rooooosh/CYR/README.md

# CYR
_Een interactief muziekspel voor mensen met de ziekte van Parkinson om hun cognitieve -en motorische vaardigheden te verbeteren._

*Projectteam: Aldo Mauro Van Hese; Rösh-Matthew Gryson*

_19/06/2025_

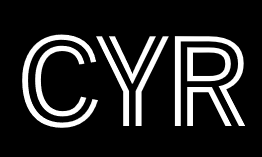
[picture p1: CYR PICS/CYR PIC.png]


## Samenvatting 

De ziekte van Parkinson is een neurologische aandoening waarvoor tot op heden nog steeds geen remedie voor bestaat. Uit literatuuronderzoek[^1] blijkt dat de verdere ontwikkeling van de aandoening een ernstige invloed heeft op de motorische vaardigheden van de persoon. Intensieve medicatie is nodig om het proces te vertragen, maar dit biedt geen permanente oplossing. Hierbij is er verder uitgediept in de Ronnie Gardiner Methode, een wetenschappelijk onderbouwde methode om cognitieve en motorische vaardigheden te stimuleren via multisensorische prikkels op basis van muziek. 

Om te voorkomen dat deze ziekte verder ontwikkeld, werd **CYR** ontworpen. **C**reate **Y**our **R**ithm is een interactief muziekspel dat helpt bij het verbeteren van de motorische -en de cognitieve vaardigheden. Deze oplossing biedt de mogelijkheid om zelfstandig muziek te maken met behulp van twee geïntegreerde modules: een **touchbox**  en een **boombox**. De gebruiker wordt opgedragen om het ritme van de afspelende muziek na te bootsen, wat een leuke maar ook uitdagende challenge vormt!

<p align="left">
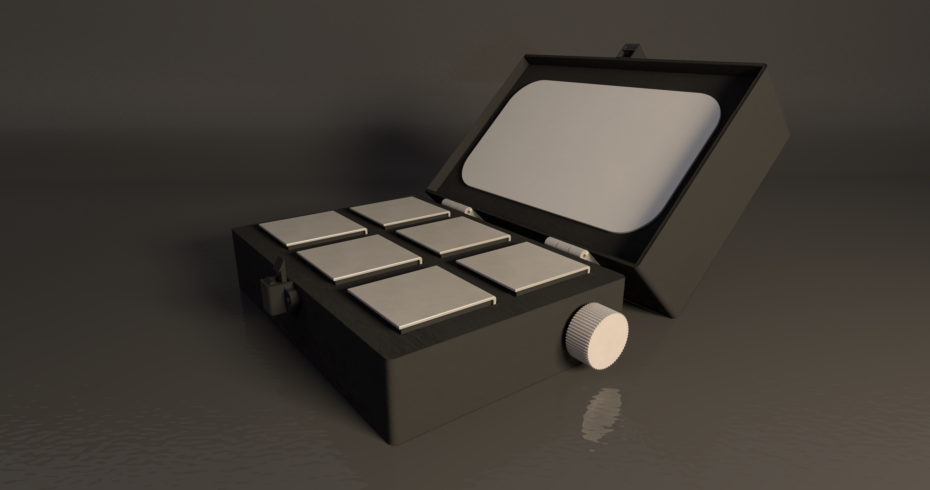
[picture p2: CYR PICS/CYR RENDER FINAAL.png]
   

> [!NOTE]
> Linken naar protocollen, rapporteringen en diepgaand onderzoek zijn te vinden in de sectie [Bijlagen](#Bijlagen).

## Introductie 

De ziekte van Parkinson is een aandoening die het vaakst voorkomt bij mensen rond 50-60 jaar. Afhankelijk van persoon tot persoon is de ontwikkelingssnelheid van de ziekte in de hersenen verschillend. Naast het innemen van medicatie staat de familie ook in voor de zorg, al is dit vaak niet evident. Naarmate de ziekte vordert, wordt het voor de familie steeds moeilijker om de benodigde zorg te bieden, waarvoor uiteindelijk wordt gekozen voor een geschikte zorginstelling om de intensieve zorg over te nemen.

Het doel van dit project is om mensen met een _vroege_ diagnose van Parkinson te begeleiden, zodanig dat de ziekte niet verergerd. De bewuste keuze om niet verder te gaan met mensen met een langere diagnose ligt aan het feit dat interactie met dagdagelijkse gebruiksvoorwerpen voor hen ingewikkelder worden. **CYR** heeft als doel om de gebruiker multisensorisch te prikkelen zodat hun cognitieve vaardigheden niet verloren gaan. De nadruk op het ontwerp ligt op het zelfstandig gebruiken van het product om de effectiviteit van de werking te garanderen. Het bestaat uit twee geïntegreerde onderdelen: een touchbox waarop muziek wordt gecreëerd en een boombox waar de gebruiker een keuze kan maken uit verschillende sets van voorgeprogrammeerde liedjes. Het ontwerp kan ook gebruikt worden in verschillende omgevingen.

We streven naar een gebruiksvriendelijk product die de gebruiker uitdaagt, maar alsnog het plezier behoudt. 

## Methodologie

Er werd in dit project gewerkt rond het 'Triple Diamond' model. Dit model bestaat uit 3 grote fasen: discover, define en develop. Het eerste semester omslaat de eerste 2 fasen. 

**Discover: |** 
Binnen de discover fase, eerste helft van het semester (week 1-6), werd individueel onderzoek gehouden van mogelijke concepten voor een vooraf gekozen doelgroep. Dit onderzoek bestond uit een literatuurstudie en het afnemen van enkele interviews. Aan het eind van deze fase werden korte pitches gehouden om de huidige concepten te introduceren. Slechts een deel hiervan kon verder bouwen op het concept. 

**Define: |** 
De define fase vond pas plaats in de tweede helft van het eerste semester (week 6-12). Na de pitches en de gekozen concepten werden teams van 2 personen samengesteld om het gekozen concept verder te zetten. Zoals de figuur van de triple diamond het laat zien, is het de bedoeling dat de concepten en oplossingen convergeren tot één werkend concept die de tweede diamond omsluit. Deze definition fase D2 werd opgesplitst in 2 waves. In elk van deze waves werden prototypes gebouwd om het concept nog meer te definiëren en bepaalde fouten in het ontwerp op te sporen. De kern van deze opdrachten was het afnemen van gebruikstests om het prototype te veranderen in functie van hun voorkeuren. 

**Develop: |**
Bij aanvang van het tweede semester (week 13) wordt de derde en laatste diamond betreden. Dit volledige tweede semester zal er gefocust worden op de develop fase. Deze fase wordt opgesplitst in 3 grote deelopdrachten elk met een bepaald doel te bereiken. 

De eerste deelopdracht heeft als doel om de fysieke, cognitieve en sensoriële ergonomie van het product te optimaliseren aan de hand van theorie, prototyping en testing. De gebouwde prototypes in wave 2 van semester 1 zullen verder verfijnd worden a.d.h.v. meerdere iteraties op beide componenten van het concept. De gebruiker zal opnieuw een keuze maken uit de verschillende iteraties waarop deze worden vastgezet tot het eind van het semester. Hierbij wordt een stap teruggenomen in het proces om zo tot voldoende feedback te komen rond de vormgeving van het product.

In develop 2 wordt de nadruk gelegd op de user experience en usability van CYR. Concreet worden de oplossingen in develop 1 verder verfijnd waarbij opnieuw gebruikstests worden uitgevoerd om zo voldoende feedback te verzamelen. 

In develop 3 wordt de focus gelegd op het optimaliseren van de esthetische vormgeving en de interactie-elementen van het prototype. Concreet wordt er gestart vanuit het verzamelen van gebruikersfeedback op basis van verschillende ontwerpvoorstellen voor zowel de look & feel van het spel als de fysieke componenten, zoals de integratie van een kliksysteem en een ondersteuningshendel. Door middel van gerichte SAM-tests en het vergelijken van alternatieve designopties zullen de voorkeuren en behoeften van de doelgroep in kaart worden gebracht. De inzichten uit deze sessies worden vertaald naar concrete aanpassingen in het eindprototype. Er zal nadruk gelegd worden op gebruiksgemak, visuele aantrekkelijkheid en praktische functionaliteit.

**Deliver: |**
Na het einde van de develop fase volgt de deliver fase. In deze fase wordt het finale concept gepresenteerd, het eindprototype vervaardigd, visuele beelden opgesteld en wordt er een video deliverable gemaakt.

<p align="left">
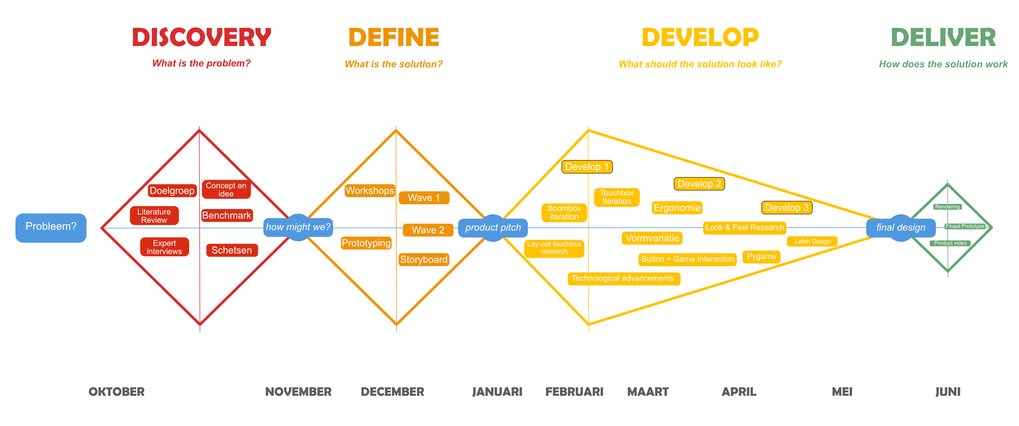
[picture p3: CYR PICS/TIJDLIJN2.jpg]
   

## Discovery

### Doestellingen
De keuze om te werken rond mensen met Parkinson maakte het noodzakelijk om voldoende met gebruikers in contact te staan bij het maken van bepaalde ontwerpkeuzes. Het grootste doel is om een product te ontwerpen dat een positieve, stimulerende invloed heeft op de gebruikers. Deze positieve invloeden zouden zowel wetenschappelijk een voordeel moeten bieden als een positieve invloed op het humeur en gedrag van de gebruiker. 

### Materiaal & methoden
Door een grondige verkenning van de onderzoeksopdracht, gebaseerd op een uitgebreide literatuurstudie en diepgaande expertinterviews, werd de verdere onderzoeksrichting zorgvuldig bepaald. Parallel aan de uitvoering van het onderzoek ontstonden de eerste conceptuele ideeën, waarbij inzichten uit de analyse direct bijdroegen aan de ontwikkeling van innovatieve oplossingsrichtingen.

#### Expert interviews (N=3)
De expert interviews werden uitgevoerd om _early_ feedback van de gebruikers te verzamelen die hielpen bij het bedenken van concepten. Uit de interviews kwam vooral naar voren dat de respondenten erkenden dat er een behoefte en marktruimte bestaat voor een nieuw product. Het zou een handig hulpmiddel zijn voor mensen met Parkinson, waarbij er minder extra medicatie moet genomen worden. 

Op basis van de interviews worden hier de belangrijkste zaken aangehaald.

| **Naam** | **Relatie tot patiënt** | **Belangrijkste inzichten** | **Opmerkingen over muziek en RGM** |
|---|---|---|---|
| **Gaston Vermeulen** | Patiënt (68 jaar) | - Parkinson sinds zijn 45ste.<br>- Kan nog stappen, maar fijne motoriek is moeilijk<br>- Heeft moeten stoppen met muziek spelen (saxofoon, fluiten), wat hij pijnlijk vond<br>- Open voor nieuwe producten, vooral met muzikale en ritmische aspecten | - Interesse in ritme/melodie-gebaseerde producten<br>- Voelt zich ongemakkelijk bij groepsactiviteiten<br>- Vond het voorgesteld concept leuk, ziet uitdaging als motivatie |
| **Monique Deurinck** | Partner van patiënt | - Mantelzorger van echtgenoot Marcel (10 jaar Parkinson)<br>- Marcel kan niet meer zelfstandig bewegen, woont in een woonzorgcentrum<br>- Merkte de symptomen op in fijne motoriek<br>- Medicatie wisselde vaak, niet altijd effectief | - Marcel vindt zingen in de woonzorgactiviteiten plezierig, minder schaamte in de sociale setting<br>- Skeptisch over effectiviteit van een product, maar ziet potentieel in motivatie en muziek |
| **Annabelle Vermeulen** | Zus van Gaston | - Mantelzorger van Gaston (23 jaar Parkinson)<br>- Helpt met dagelijkse taken, voelt emotionele impact van zijn achteruitgang<br>- Gaston heeft mentale en fysieke moeilijkheden, confronterend voor beiden<br>- Positief over nieuwe oplossingen | - Gaston heeft muzikale achtergrond, voelt geluk bij het spelen van muziek<br>- Gelooft dat muzikale en fysieke acties effectief kunnen zijn, vooral met een motiverende insteek |

#### Literatuuronderzoek (N=10)
Literatuuronderzoek uitvoeren is cruciaal om goed geïnformeerd te zijn wanneer je werkt rond een doelgroep met een bepaalde aandoening of ziekte. Via een internet research werd tal van relevante informatie gevonden die het project verder kon helpen bij het opstellen van een goede onderzoeksvraag. De literatuurstudie wees uit dat muziek het meest prominente focuspunt vormt voor verdere ontwikkeling binnen dit onderzoek. Het is bewezen dat muziek en ritme een positieve invloed hebben op mensen met Parkinson.

#### Conceptselectie
De concepten die uit het vooronderzoek kwamen, waren allemaal gericht op muziek. De keuze om met **CYR** verder te gaan, was vanzelfsprekend. Dit concept sluit het beste aan bij het verlopen onderzoek. In de andere concepten stond muziek meer centraal. De kern bij **CYR** ligt vooral bij ritme en timing die een oplossing zou moeten geven voor dit project.
<p align="left">
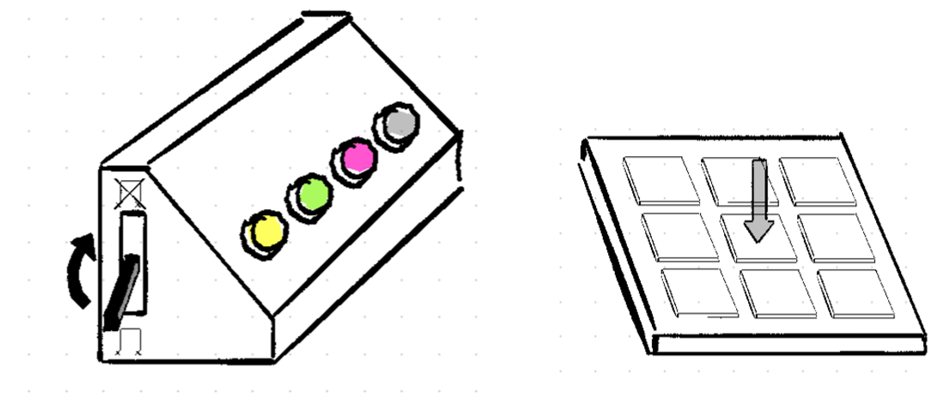
[picture p4: CYR PICS/modules.png]
   

## Definition (N=10)

### Doelstellingen
Vanuit het vooropgestelde onderzoek werd een prototype gebouwd, die het ritme van muziek kon construeren op een gekozen set van liedjes. Vanuit de eerste wave werd het prototype aangepast aan de voorkeur van de gebruiker. Uit deze feedback werden de volgende stappen genomen voor wave 2.

### Materiaal & methoden
De gebruikstesten zullen plaats vinden in 2 waves. De eerste wave legt de focus op de interactie tussen het prototype (zowel touchbox als boombox) en de gebruiker. Hierbij was de bedoeling om enige ongemakken tijdens het gebruik op te sporen en de interactie zo goed mogelijk te optimaliseren. Er werd getest met drukknoppen (verschillende groottes) en hendels waarvan de functies later worden besproken. Wat getest zal worden in wave 2 is afhankelijk van de feedback uit wave 1. Voor het prototypen werd er gebruik gemaakt van mdf, karton, metalen plaatjes en Makey Makey. 

Er zijn twee prototypes van de boombox in verschillende formaten gemaakt om de voorkeuren weer te geven die in elk van de waves naar voren kwamen. De boombox heeft als doel om een liedje te selecteren en biedt de keuze om dit met of zonder percussie te doen via een keuzehendel of aan-/uitknop. Het grotere prototype kreeg aan de zijkant de hendel, het kleinere prototype de knop. Deze keuze was onbewust en kon uiteraard aangepast worden indien nodig. Op beide boomboxen werden grote knoppen gemonteerd die de keuze liet geven uit een aantal liedjes. 

Vooraf aan de bouw van het touchbox werden de dimensies zodanig gekozen dat er genoeg plaats voor de elektronica en de plaatjes die moeten bevestigd worden. In totaal werden 9 gelijke metalen plaatjes gemonteerd, 3 plaatjes per 3 rijen. In het verdere verloop van dit project zou kunnen gewerkt worden met minder of meer plaatjes, deze keuze kan nog verandert worden in de loop van de tijd. 

_Foto 1: Touchbox_;
_Foto 2: Kleine boombox_;
_Foto 3: Grote boombox_

<p align="left">
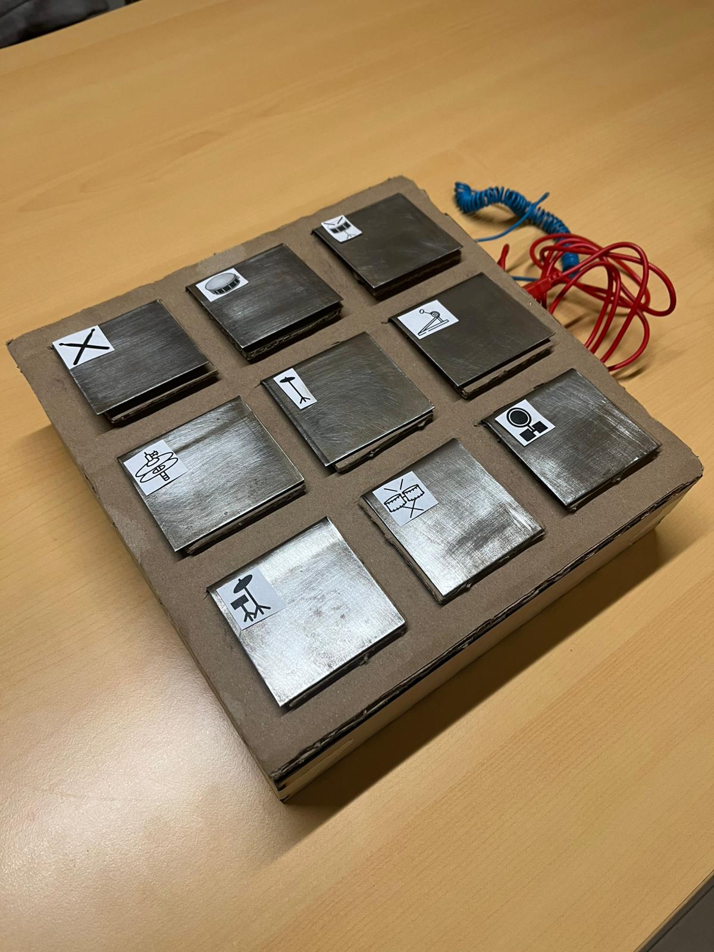
[picture p5: CYR PICS/Touchbox2.jpg]
  
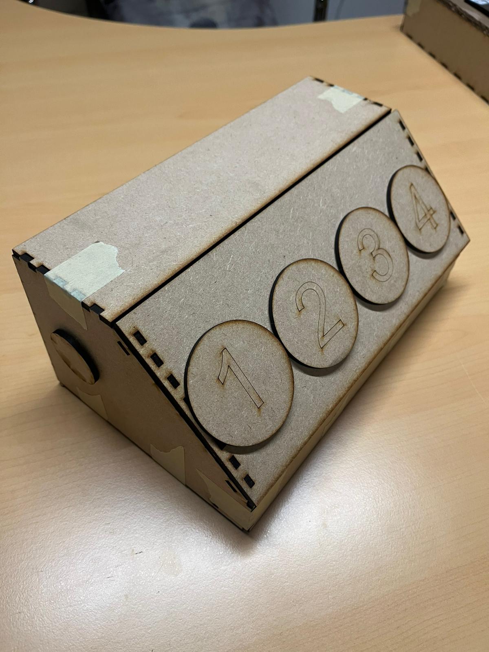
[picture p6: CYR PICS/Hoofdbox1.jpg]
  
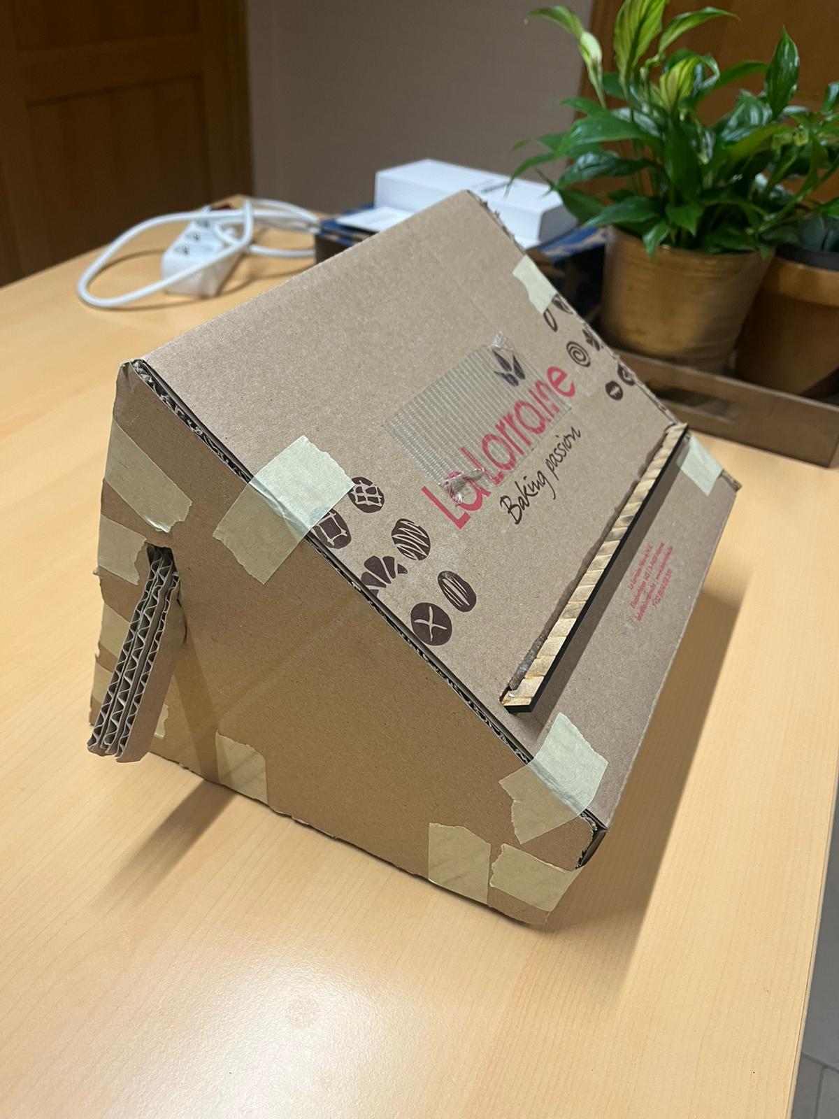
[picture p7: CYR PICS/Hoofdbox2.jpg]
  

In wave 1 werden de verschillende toetsen van de touchbox aangeduid met hun bijhorende naam. Door de vele verwarring en beperkte kennis over een drumstel werd er overgeschakeld naar een alternatief met icoontjes in wave 2. Door het gebruik van icoontjes op de toetsen kreeg de gebruiker meer voeling om het ritme goed na te bootsen.

<p align="left">
  
  

#### Inspiratie
Het idee om een muziekspel te maken stamde af op het idee dat leek op Guitar Hero, een spel waarbij de gebruiker wordt opgedragen om te tikken op de volgorde van toetsen die worden gegeven. Wanneer de speler op een verkeerde toets drukte, of deze te laat indrukte heeft de speler verloren en moet deze proberen het level opnieuw te spelen. 

In wave 2 werd een spel geprogrammeerd waarin **CYR** op een vergelijkbare manier functioneert. Het spel werd gemaakt met Protopie waarbij eenvoudig verschillende layouts werden gemaakt. De gebruiker krijgt aan het begin van een liedje een opeenvolging van voorgeprogrameerde "pictogrammen" te zien op het scherm van de boombox die corresponderen met de icoontjes op de touchbox. In dit geval werd er gebruik gemaakt van een Ipad als scherm.

Het doel is om op het juiste moment deze toetsen in te drukken die vervolgens mooi aansluiten op het ritme van de afspelende muziek. Wanneer de gebruiker een foute toets indrukt of te laat indrukt wordt er niet opnieuw gestart, maar wordt er simpel weg aangegeven dat de handeling niet correct werd uitgevoerd. Om op deze manier een spel te creëren dat de uitdaging blijft behouden met de gebruiker, slaagt **CYR** erin om zowel cognitie als motoriek te blijven trainen.

<p align="left">
  
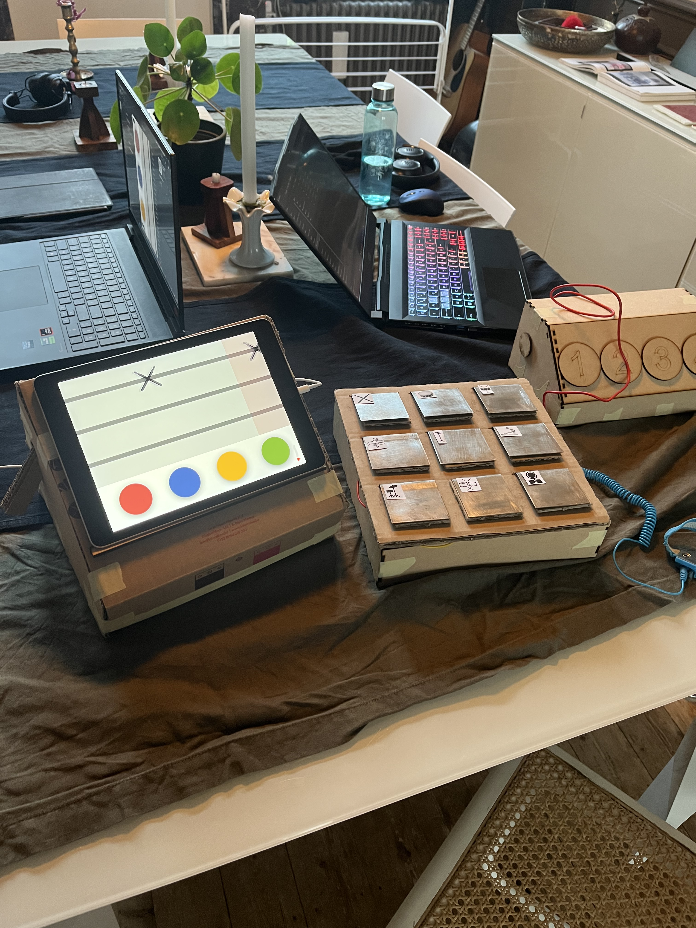
[picture p9: CYR PICS/CYR met Ipad volledige setup 1.jpeg]
  
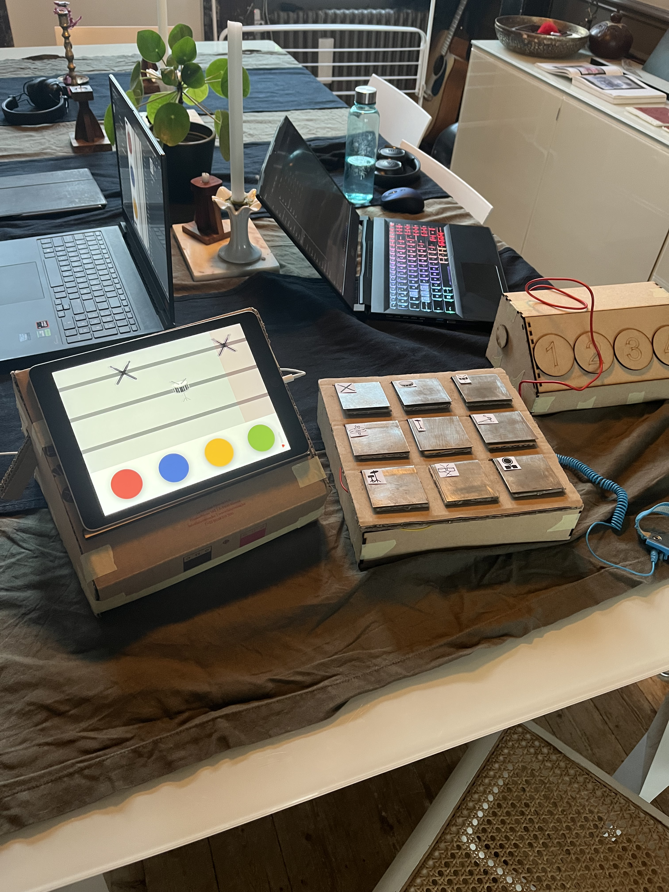
[picture p10: CYR PICS/CYR met Ipad volledige setup 2.jpeg]
  

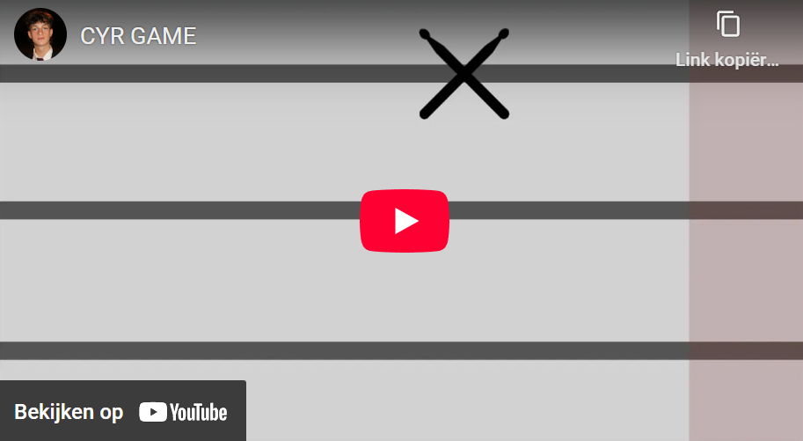
[picture p11: CYR PICS/Thumbnail.png]
[](https://youtu.be/sCeQrx-kPlM)

#### Makey Makey
Het afspelen van geluid na indrukken van de toetsen wordt mogelijk gemaakt door [Makey Makey](https://makeymakey.com/). 

<p align="left">
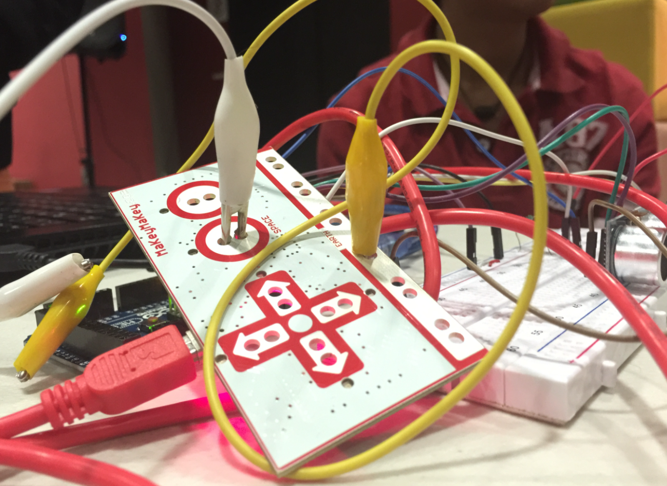
[picture p12: CYR PICS/Makey Makey 1.png]
  
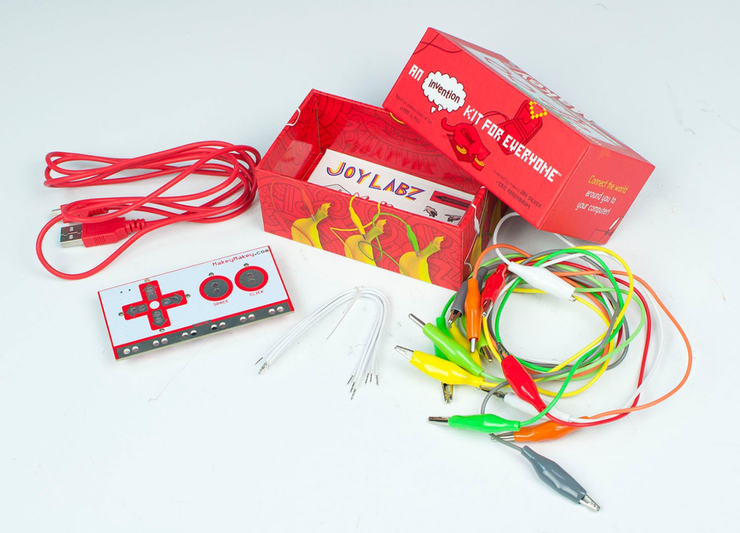
[picture p13: CYR PICS/Makey Makey 2.png]
  

Om muziek te imiteren wordt gekozen om verder te werken op drumpercussie. Elk van de toetsen wordt gelinkt met een andere component van een drumstel. De hendel of aan-/uitknop die eerder werd aangehaald, geeft de mogelijkheid om de percussie van het afspelende lied aan of uit te zetten. Dit kan voor de gebruiker een grotere uitdaging vormen. Om de touchbox te kunnen gebruiken werd voor het uitvoeren van de test gevraagd aan de gebruiker om een polsbandje om te doen zodat er directe verbinding is met de Makey Makey, die op zijn beurt is verbonden met een laptop. 

> [!IMPORTANT]
> Makey Makey maakt gebruik van capacitive touch waardoor een simpele aanraking met één van de toetsen al een geluid creëert. 

### Resultaten
In wave 1 kreeg het concept positieve feedback. Gebruikers vonden het een leuk en uitdagend product, zeker voor mensen zonder ervaring met muziekspelen. Ze waardeerden de interactie met de touchbox en vonden het prettig dat ze geen knoppen hoefden in te drukken - het aanraken van de plaatjes was voldoende om feedback te krijgen. Voor mensen met Parkinson kon dit een uitdaging zijn, maar één die te overwinnen was. Een verbeterpunt was de lichte vertraging tussen het aanraken van het plaatje en het afspelen van het geluid.

Het grootste resultaat uit wave 2 was de goede ervaring met het gemaakte spel. De gebruikers vertelden dat het een leuke uitdaging was waarbij ze een duidelijke verbetering merkten bij het meermaals spelen van het spel. De moeilijkheid werd door elke gebruiker anders ervaren, dit is dan ook een persoonlijke kwestie van muziekvaardigheden. Dit is iets wat verwacht werd bij het starten van deze wave en niet als probleem werd gezien omdat het plan was om dit spel in verschillende moeilijkheden/niveaus te maken. 

Een aantal gebruikers hadden wel kritiek op de kwaliteit van het spel. De icoontjes waren niet altijd perfect getimed en vielen soms buiten het ritme. Dit kwam door de beperkingen van ProtoPie, waardoor het lastig was om de beweging van de icoontjes nauwkeurig te programmeren.

> [!NOTE]
> De gebruikstests werden uitgevoerd volgens de **Wizard of Oz** methode. _"De Wizard of Oz methode is een gemodereerde onderzoeksmethode waarbij een gebruiker interageert met een interface die autonoom lijkt te zijn, maar (geheel of gedeeltelijk) bestuurd wordt door een mens."_[^2]
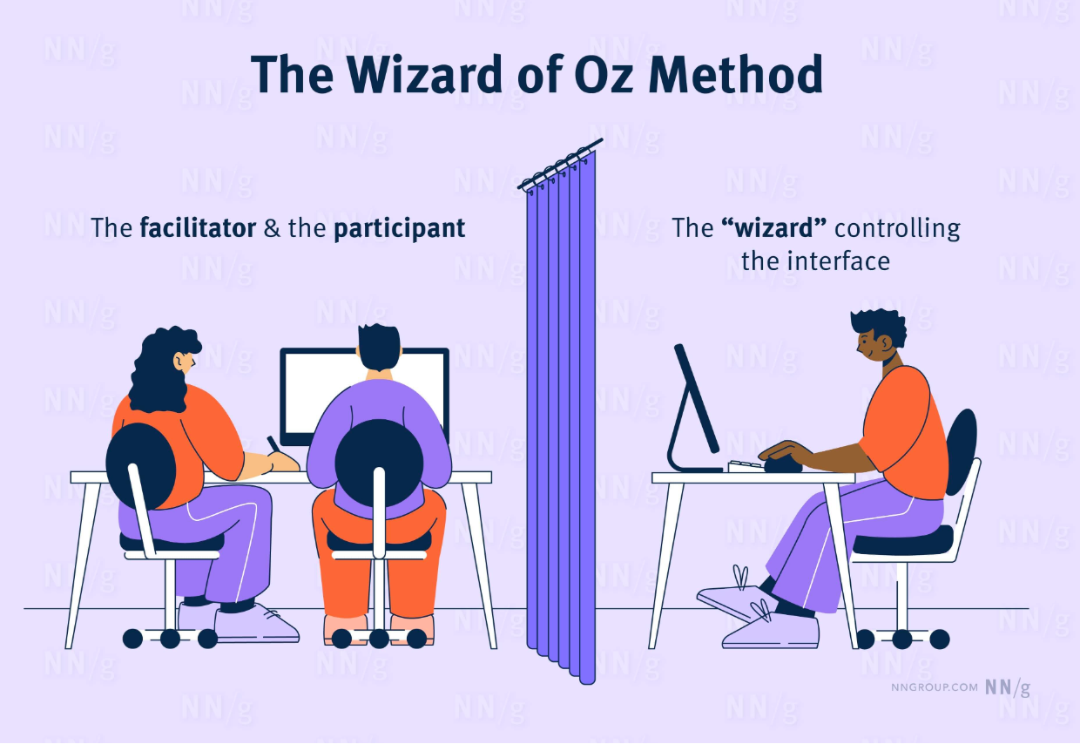
[picture p14: CYR PICS/The Wizard of Oz.png]


#### Enkele foto's met de gebruikers
<p align="left">
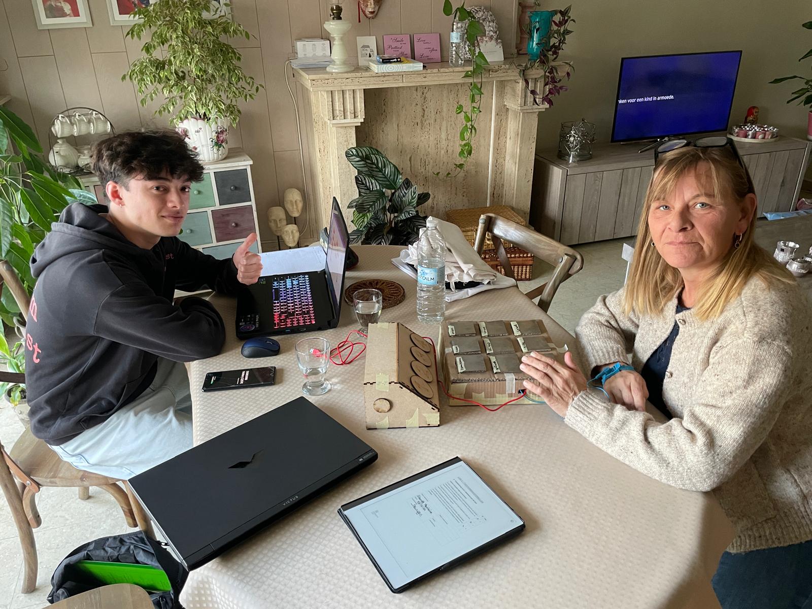
[picture p15: CYR PICS/TEST.jpg]
  
  

### Conclusies & implicaties
Op basis van de resultaten tijdens de discovery fase en uit de definition fase werd er een lijst opgesteld met de belangrijkste punten in het (voor)onderzoek:

#### Prototypes
- Een spel op basis van muziek zou de motivatie verhogen om hun conditie beter te onderhouden.
- De groottes van beide boomboxen en de touchbox zijn optimaal alsook voor de groottes van de toetsen.
- De vorm van drukknoppen op de touchbox zijn optimaal en groot genoeg van dimensies.
- Een extra uitdaging zoals meerdere spelvormen zouden het plezier nog meer naar boven halen.
- De delay op het indrukken van de toetsen was een vaak voorkomende storende factor.
- Aanduiding op de toetsen welk geluid welke toets maakte, zorgde voor een beter begrip.
- Het ritme kon iets beter nagevolgd worden m.b.v. de Ipad die werd gemonteerd aan de boombox.
- De toetsen, verbonden met Makey Makey, waren tè responsief. M.a.w. als de toets voor langere tijd werd ingedrukt, kreeg je een rare vervorming van het geluid.

#### Gebruikers
- Er was vaak een gebrek aan kennis over de verschillende componenten (van een drumstel).
- In een aantal gevallen waren de gebruikers niet compatibel voor het gebruik van het prototype door bepaalde menselijke factoren (verbinding i.v.m. Makey Makey).
- Het duurde een aantal keren voordat er werd onthouden welke toets welk geluid maakte.
- De gebruikers lieten een goed gevoel achter na afronden van de tests.
- Gebruikers met duidelijkere symptomen (vb. tremor hand) hadden meer moeite om op een toets te drukken.

> [!IMPORTANT]
> **Design requirements**
>  - 1.1 De touchbox bevat een minimale hoogte om elektronica te bewaren.
>  - 1.2 De boombox bevat een minimale grootte voor het ondersteunen van een scherm.
>  - 2.1 De touchbox produceert geluid door een enkele aanraking met één van de toetsen.
>  - 2.2 Het indrukken van de knoppen op de touchbox gebeurt aan de hand van capacitive touch.
>  - 2.3 Elke toets wordt afgebeeld met een ander symbool.
>  - 3.1 De boombox heeft een functieknop aan de zijkant om het ritme van muziek aan/uit te schakelen.
>  - 3.2 De boombox bevat verschillende knoppen om een keuze te maken uit verschillende liedjes.
>  - 4.1 De dimensies van de touchbox (25,5cm x 17,5cm) maken het mogelijk deze makkelijk op te bergen.
>  - 4.2 De drukknoppen hebben een minimale diameter 4-6cm om een keuze uit liedjes te maken.
>  - 4.3 De toetsen bevinden zich in een dicht gestapeld raster (2x2, 3x2, 3x3) om multi-touch mogelijk te maken.

## Bill of materials

- Natuurhout (vooral duurzaam, maar kwaliteitsvol hout)
- Roestvrij staal
- Arduino
- Kunststof drukknoppen/toetsen
- Digitale interfaces

## Kritische reflectie
Bij aanvang van dit project werd er veel progressie gemaakt. Na de vorming van de groepen werd er overlegd wat er goed was en wat er nog kon verbeterd worden aan het concept met de feedback gekregen uit de pitch. Hierna werd er gebrainstormd over wat er zou kunnen worden getest voor de verschillende waves. Een overgang werd gemaakt tot de prototyping fase, dit werd misschien wel wat te snel gedaan en had als gevolg dat er tijdens de tests af en toe iets onverwachts plaatsvond. Dit waren dingen zoals Protopie dat een update nodig had, een verbinding van de Makey Makey die loskwam etc. Desondanks bracht dit de positieve resultaten uit de tests niet neer. 

Waar er vooral last werd ervaren, was het contacteren van gebruikers om de waves mee uit te voeren. Door de moeilijke doelgroep was er geen optie waar alle tests op een gelijk tijdstip zouden kunnen worden uitgevoerd. De gekozen doelgroep heeft nog geen extreme zorg nodig en is niet altijd even mobiel. De meeste gebruikers hadden liever een afspraak moment bij hen thuis, wat soms voor moeilijkheden zorgde. 

Wave 1 werd initieel afzonderlijk uitgevoerd, maar een grondigere voorafgaande analyse had wenselijk geweest alvorens de momenten definitief vast te leggen.
Naar aanleiding van de eerste test binnen wave 1 werd besloten om de daaropvolgende waves simultaan af te nemen. Er werd met een tiental mensen in contact gestaan, maar door een aantal factoren kon er geen gepast moment ingepland worden om het prototype te testen. Dit had als gevolg dat er een test werd uitgevoerd met een persoon die geen Parkinson heeft, maar wel vaak in contact heeft gestaan met de doelgroep en nuttige feedback heeft kunnen geven.

Deze korte tegenslagen terzijde, verliep de samenwerking en de vooruitgang die werd gemaakt in het proces goed. Na het voltooien van de waves kan het project naar de volgende fase. De waves hebben een grote impact gehad op het project en hebben de nodige motivatie gegeven om verder te werken aan het project. De gebruikers gaven ook aan nog in contact te willen staan, wegens de grootte interesse in het concept. In de toekomst zullen deze mensen de mogelijkheid krijgen om als eersten het volmaakt prototype te testen.

## Develop 1: Definiëren van gebruiksinterfaces (N=3) 

### Doelstellingen
De oplossingen die werden gebracht in wave 2 van de definition fase, zullen verder verfijnd worden waarbij opnieuw een aantal gebruikstests worden afgelegd. Het doel is om de centrale interfaces van beide componenten vast te leggen met een aantal gebouwde iteraties.

### Materiaal & methoden
Voor deze deelopdracht wordt een stap teruggenomen waarbij er opnieuw wordt getest op de layout van de interfaces van zowel de boombox en de touchbox. Om de interfaces van de touchbox en de boombox vast te leggen, werden een aantal iteraties gebouwd:
- De touchbox bevat variaties met 4, 6, en 9 (origineel) toetsen
- De boombox bestaat uit 4 mogelijke varianten: 4 kleinere knoppen met extra respons, 2 kleinere knoppen, een draaiknop en een draaiwiel

**Touchbox**

Verschillende iteraties van de touchbox werden gemaakt met een verminderd aantal toetsen. Het origineel bevatte teveel knoppen waardoor een groot aantal niet werden gebruikt tijdens een gebruikstest. Deze bevinding stamde af van de definition fase. Ook is het moeilijk om aan elke knop een ander icoon aan te linken aangezien dat een drumstel soms overlappende elementen bevat. 

> _"Hoe meer knoppen hoe verwarrender"_
> 
> _- Een gebruiker_

Er werd ook onderzocht naar de latency van de touchbox. De kloof tussen het horen van het geluid na het indrukken van een toets is voor de meeste gebruikers nog steeds te groot. Om te zien of dit aan de software of hardware ligt zal dit probleem in vrijwel elke deelopdracht worden aangekaart. Bij deze deeldpdracht ligt de focus bij het veranderen van de **<ins>software</ins>**: het eenvoudige programma scratch wordt hierbij vervangen door Protopie als poging om deze latency te doen verminderen.

_Foto 1: Touchbox met 9 toetsen (origineel); Foto 2: Touchbox met 6 toetsen; Foto 3: Touchbox met 4 toetsen_
<p align="left">
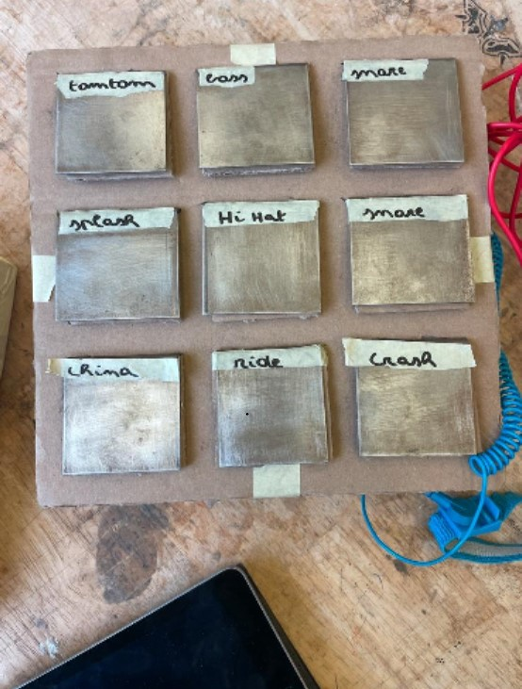
[picture p16: CYR PICS/Touchbox met 9 toetsen (origineel).jpeg]
  
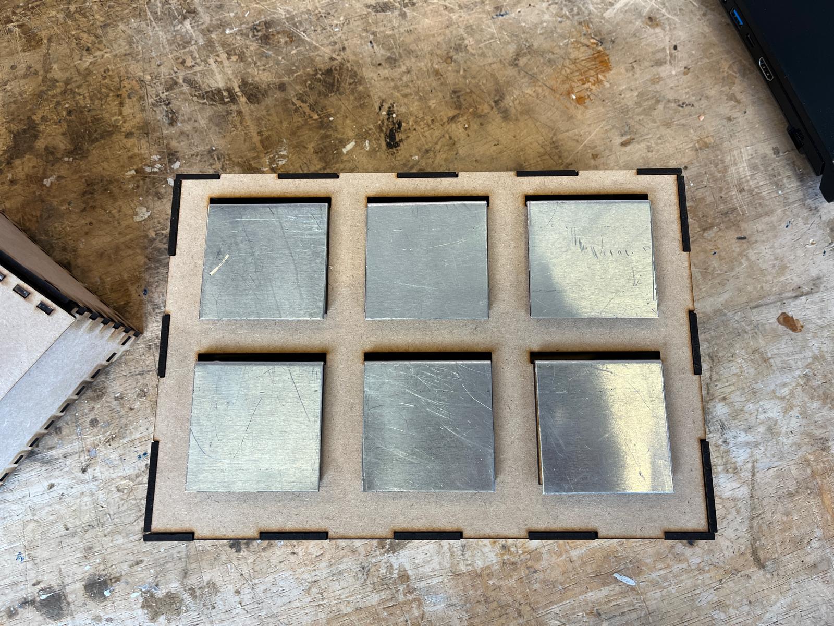
[picture p17: CYR PICS/Touchbox met 6 toetsen.jpeg]
  
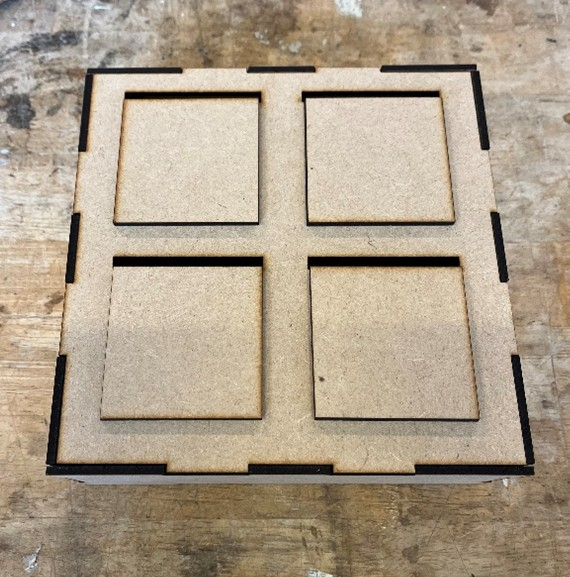
[picture p18: CYR PICS/Touchbox met 4 toetsen.jpg]
  

**Boombox**

De verschillende iteraties op de boombox bevatten interfaces die elk op een andere manier worden gebruikt.

- **1.** Het originele prototype dat 4 keuzeknoppen bevatte voor het selecteren van een liedje, werd opnieuw gebouwd met een viertal kleinere knoppen waarbij een extra respons wordt toegepast na indrukken van een knop. 

- **2.** De interface met 2 knoppen dient op gelijkaardige wijze gebruikt te worden. De interface bestaat uit een lijst van liedjes die voorgeprogrammeerd zijn en bevat ook de optie om eigen liedjes up te loaden binnen de software.
  > _"Na mum van tijd zul je die voorgeprogrammeerde liedjes zat zijn"_
  > 
  > _- Een gebruiker_
  
  De linkerknop zorgt voor het "scrollen" van de lijst naar onder, de rechterknop zorgt voor de navigatie naar boven. Om een keuze te maken uit een liedje worden simultaan beide knoppen ingedrukt. 

- **3.** De draaiknop heeft als mogelijkheid om opnieuw uit een lijst van liedjes te scrollen via een draaibeweging naar links of naar rechts. Om een liedje te selecteren wordt dan op de knop gedrukt. 

- **4.** Het draaiwiel bevat een andere manier voor het selecteren van een liedje. Het draaiwiel is via een intern draaiwiel in het iPad scherm verbonden. Wanneer er met het draaiwiel gedraaid wordt, dan zal de digitale schijf ook meedraaien volgens de beweging van het draaiwiel.

_Foto 1: Originele boombox; Foto 2: Boombox met 4 drukknoppen; Foto 3: Boombox met draaiwiel; Foto 4: Boombox met 2 drukknoppen; Foto 5: Boombox met draaiknop; Foto 6: Bird's-eye view interfaces_
<p align="left">
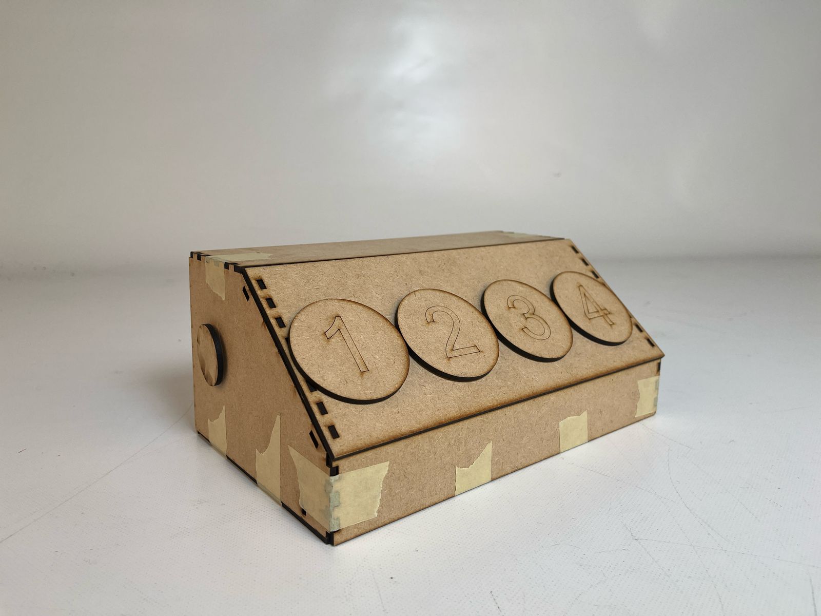
[picture p19: CYR PICS/Originele boombox.jpeg]
  
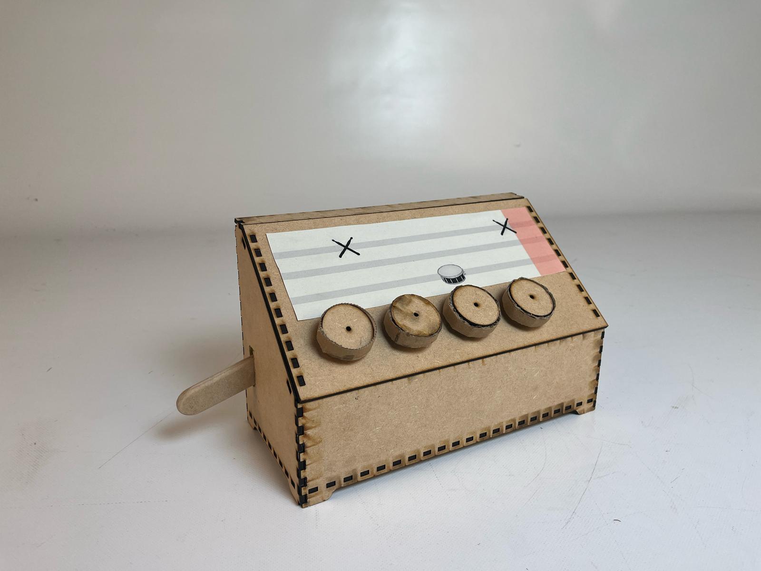
[picture p20: CYR PICS/Boombox met 4 drukknoppen.jpeg]
  
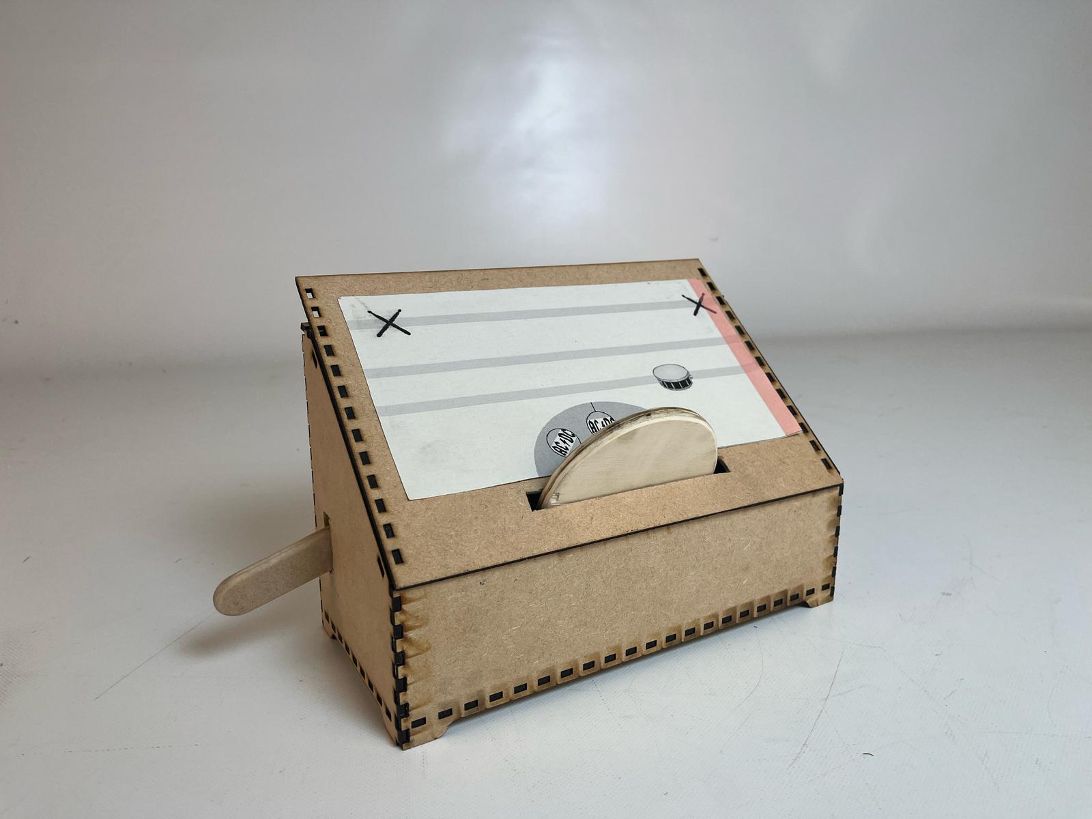
[picture p21: CYR PICS/Boombox met draaiwiel.jpeg]
  
<p align="left">
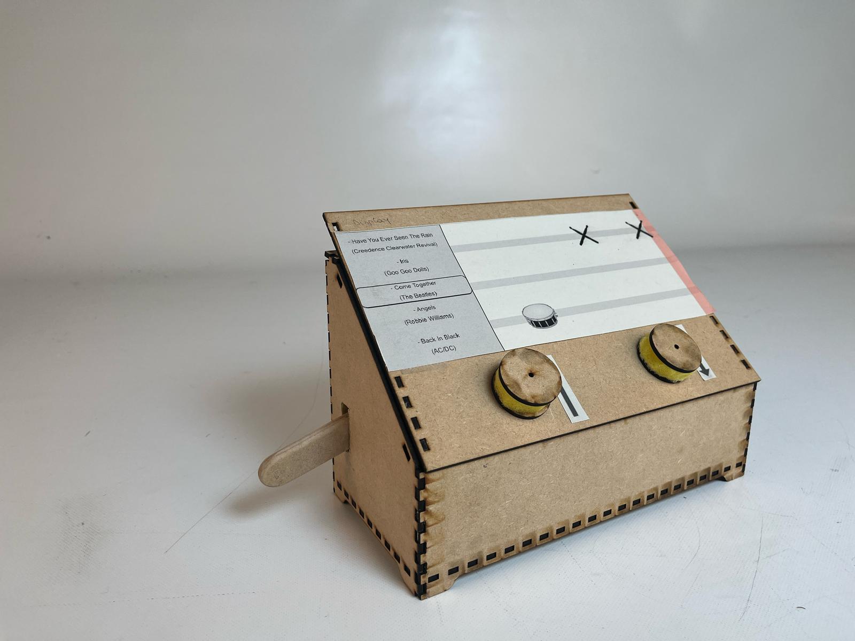
[picture p22: CYR PICS/Boombox met 2 drukknoppen.jpeg]
  
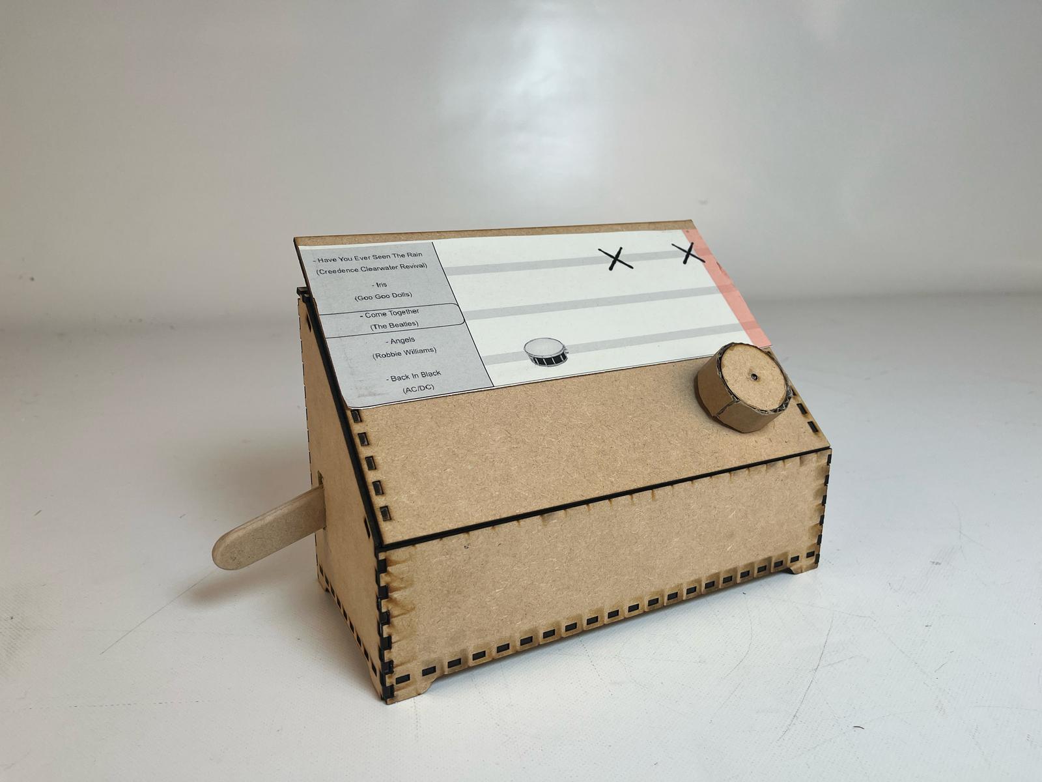
[picture p23: CYR PICS/Boombox met draaiknop.jpeg]
  
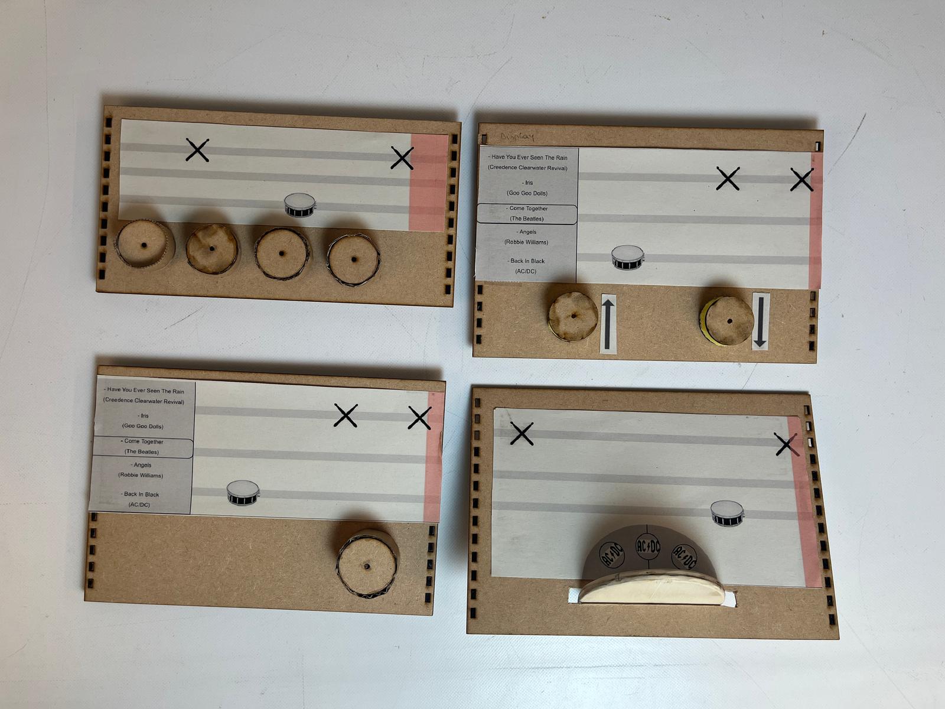
[picture p24: CYR PICS/Bird's-eye view interfaces.jpeg]
  

> [!IMPORTANT]
> Verdere ontwerpkeuzes worden toegelicht in [Protocol develop 1](https://ugentbe-my.sharepoint.com/:b:/g/personal/rosh_gryson_ugent_be/EYnQ5_UpWrZMqZonUhhwbUYB3qiD7yPpWkR4IYsoJCzTBQ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)

### Resultaten

De volgende resultaten komen rechtstreeks van het [rapport](https://ugentbe-my.sharepoint.com/:b:/g/personal/rosh_gryson_ugent_be/EcLrkE5KQL9KjGkvioypGBIBMkkocPpwzSfuyE07QG-s8w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) en zullen hier kort toegelicht worden.

---

`Gebruiker 1:` Anne <br>
`Gebruiker 2:` Sofie <br>
`Gebruiker 3:` Pieter Jan

---

#### **Touchbox MOS Test**
- 1 - zeer slecht
- 5 - uitstekend

|**Gebruiker** | **Score** | **Beperking**|
|-|-|-|
| Anne | 3 | Licht Storend | 
| Sofie | 2 | Storend|
| Pieter Jan  | 4 | Waarneembaar, maar niet storend  |
| | *Gem.: 3* ||
  
  De testpersonen ervaarden de latency op de touchbox gemiddeld gezien nog als licht storend.

#### **Varianten Touchbox** 
- 1 - meest voorkeur
- 3 - minst voorkeur

| | **9 toetsen** | **6 toetsen**| **4 toetsen** |
|-|-|-|-|
| Anne | 2 | 1 | 3|
| Sofie | 2 | 1 | 3|
| Pieter Jan  | 3 | 1  |  2|
| || *Favoriet* 

#### **Varianten Boombox** 
- 1 - meest voorkeur
- 4 - minst voorkeur

| | **Draaiknop** | **2 drukknoppen**| **4 drukknoppen** | **Draaiwiel**|
|-|-|-|-|-|
| Anne | 1 | 2| 4 | 3|
| Sofie | 2  |4  | 3 | 1|
| Pieter Jan  |1| 3 | 4  |  2|
| | *Favoriet* 

Als poging om de compactheid van CYR te bewaren, werd volgende onderzoeksvraag gesteld aan de gebruikers:

> "Zou u beide onderdelen (touchbox en boombox) liever aan elkaar verwerkt hebben of toch eerder als aparte modules behouden?"

Na een aantal interessante standpunten werden zowel de meest voorkomende voor - en nadelen gerangschikt in een tabel. 
  |**Voordelen**|**Nadelen**|
  |-|-|
  |"Zo lijkt het wat logischer, het product voelt meer aan als 1 geheel"| "Het is mogelijks moeilijker om op te bergen" |
  |"Voelt ergonomischer aan (scherm zit automatisch op een goede positie)"| "Aangezien het 1 geheel is, is het zwaarder"|
  |"Verbinding tussen elektronica zal eenvoudiger zijn"||

### Conclusies en implicaties
- Er kan gesteld worden dat de latency op de touchbox nog een probleem is, merendeel van de gebruikers merkt dit nog op en stoort zich er aan. Het veranderen van de software van Scratch naar ProtoPie voldoet niet. Een mogelijke stap naar andere hardware is een oplossing.
- Wanneer de gebruikers de verschillende iteraties op de touchbox lieten zien, werd er 1 ontwerp duidelijk vooropgesteld. Dit is het ontwerp met 6 toetsen. Hierbij werden de gebruikers ook gestimuleerd om na te denken over de hoeveelheid knoppen men dan nog tot hun beschikking zouden hebben. De eerste keus bleef behouden, dit betekent dat meer dan 6 knoppen voor de gebruiker al overbodig lijkt.
- Wanneer op dezelfde wijze de varianten op de interface van de boombox werden voorgelegd, was er een duidelijke voorkeur voor de variant met de draaiknop. De draaiknop leek de goede oplossing voor dit probleem. Het integreren van het selecteren van de liedjes in de software leek voor alle gebruikers efficiënter om zo te kunnen selecteren via 1 knop. 
- De grote van het ontworpen scherm blijkt goed te zijn. Het gaat eerder over de grote van de iconen i.p.v. de grote van het scherm.
- het spel zelf zit goed ineen, er kan mogelijks nog gespeeld worden met het kleurenpalette en een deeltje van de layout.
- Een fysieke hendel is onnodig. De functie hiervan kan worden geïntegreerd in de gekozen interface.
- De algemene mening van de gebruikers geeft weer dat ze liever de touchbox en boombox aan elkaar zouden hebben. Dit haalt een aantal praktische problemen weg en is de voor de hand liggende keuze.

> [!IMPORTANT]
> **Design requirements** 
>  - 1.3 De touchbox en boombox bevatten snap/klikverbindingen om deze aan/uit elkaar te halen.
>  - 1.4 Het product is zo compact mogelijk.
>  - 2.4 De interface van de boombox is zodanig ontworpen zodat de interactie hiermee geen overbodige elementen bevat.
>  - 2.5 Voor elke gebruiker is er een uitdagend niveau beschikbaar.
>  - 3.3 Het product maakt duidelijk met welke elementen de gebruiker kan interageren.
>  - 3.4 De touchbox is responsief en heeft een lage latency.
>  - 3.5 De hendel moet niet fysiek aanwezig zijn op de boombox.
>  - 4.4 De knoppen van de touchbox bevatten een grootte van 6x6cm.
>  - 4.5 De interactie met de boombox gebeurt aan de hand van fysieke knoppen.

## Develop 2: Focus op ergonomie (N=4)

### Doelstellingen
Uit deelopdracht 3 werden de interfaces voor zowel de touchbox als boombox vastgelegd. Het doel van deelopdracht 4 (develop 2) is nadruk leggen op de usability en user experience van CYR. 

### Materiaal & methoden
Er zal voor deze test een scherm, een draai/drukknop en nieuwe elektronica worden voorzien voor het afnemen van de tests en om een betere user experience te bieden voor de gebruikers. De draaiknop zal voorzien zijn van textuur en tactiele feedback. Een sensorial board wordt gemaakt om de gebruiker een keuze te bieden uit een aantal texturen. Een ander soort paneel wordt opgesteld om de grootte van de draaiknop te bestuderen. Gelijkaardig aan het sensorial board, worden een zestal draaiknoppen met verschillende diameters voorgesteld aan de gebruiker. Hun taak om een voorkeur te kiezen waarop verder gewerkt zal worden in de volgende deelopdracht. 

_Foto 1: Textuurbord; 
Foto 2: Bord met draaiknoppen van verschillende diameters: 30mm; 35mm; 40mm; 45mm; 50mm; 55mm_
<p align="left">
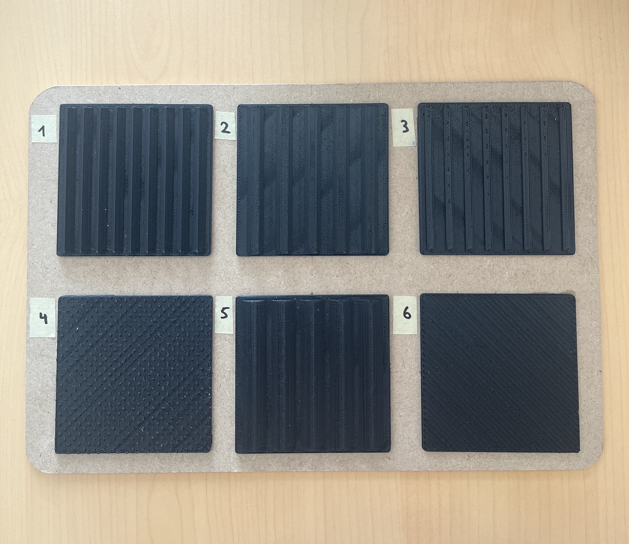
[picture p25: CYR PICS/Textuurbord.jpeg]
  
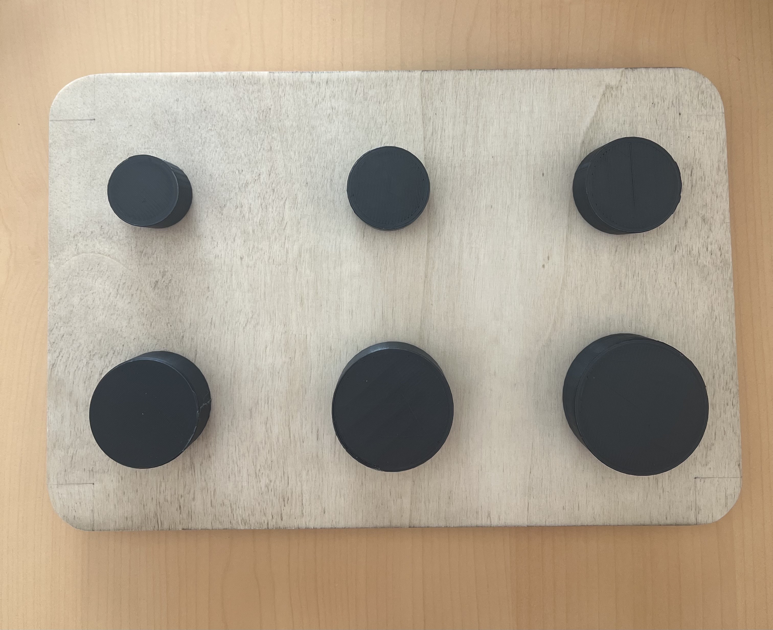
[picture p26: CYR PICS/Draaiknopbord.jpeg]
  

> [!IMPORTANT]
> Verdere ontwerpkeuzes worden toegelicht in [Protocol develop 2](https://ugentbe-my.sharepoint.com/:b:/g/personal/rosh_gryson_ugent_be/EZr1qvLegvdGhiyvLIi9aaYBGahtcbnpVLFXi5PUhK0NEA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)

Zoals in vorige deelopdrachten wordt vermeld, is het latentieverschil tussen het aanraken van het metalenplaatje en het horen van het geluid nog een te grote kloof voor onze gebruikers. Bij deze deelopdracht ligt de focus bij het veranderen van de **<ins>hardware</ins>**: als poging om de latency te verminderen, zal de Makey Makey nu worden vervangen door Arduino. 
Er wordt gewerkt met een aantal Arduino componenten:

- Arduino Nano
- 12 Key Capacitive I2C Touch Sensor (MPR121)
- MP3-TF-16P V3.0 (DF player mini)
- Weerstand 1,2kΩ
- Speaker 3W - 5Ω

_Foto 1: Arduino Nano met DF player mini en speaker; 
Foto 2: I2C Touch Sensor met krokodillenklemmen; 
Foto 3: Volledige opstelling_
<p align="left">
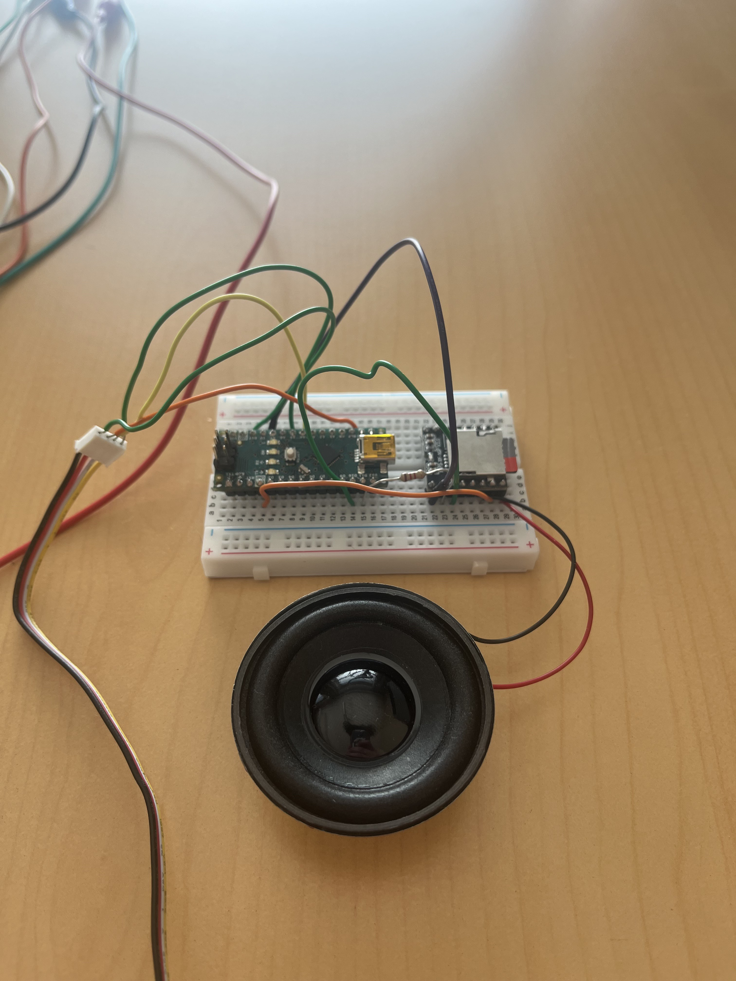
[picture p27: CYR PICS/Arduino1.jpeg]
  
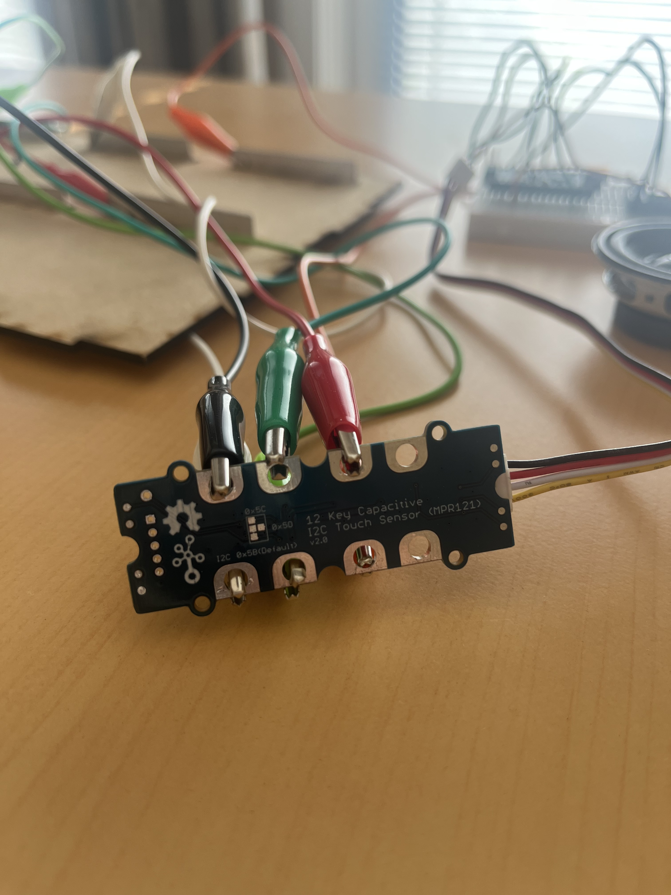
[picture p28: CYR PICS/ArduinoMPR121.jpg]
  
  

Via een breadbord (groot wit bordje) worden de verschillende componenten met _jumper wires_ met elkaar verbonden. De DF player mini bevat een micro SD kaart met een aantal geluiden. De krokodillenklemmen aan de touch sensor zijn verbonden met de metalenplaatjes. De speaker die is verbonden met deze mini player zet de aanraking van één van de toetsen om in geluid. Ook deze touch sensor bevat capacitive touch waardoor een enkele aanraking met de plaatjes al volstaat om geluid te creëren.

> [!NOTE]
>  De bijhorende code om een aanraking om te zetten naar een geluidsfragment, is te raadplegen via volgende [link](./Code/Arduino/I2C_Touch_Sensor). 

Om te voldoen aan **design requirement 1.4**:
> Het product is zo compact mogelijk

Ondergaat de boombox opnieuw een vormvariant. Bij deze variant wordt de boombox rechtstreeks verbonden met de touchbox waardoor deze wordt opgeborgen als één grote "doos". De boombox wordt verbonden met scharnieren waardoor deze makkelijk open en dicht kan. Ook zorgt deze variant voor een extra laag bescherming voor de touchbox, waardoor een langere productlevensduur kan gegarandeerd worden.

<p align="left">
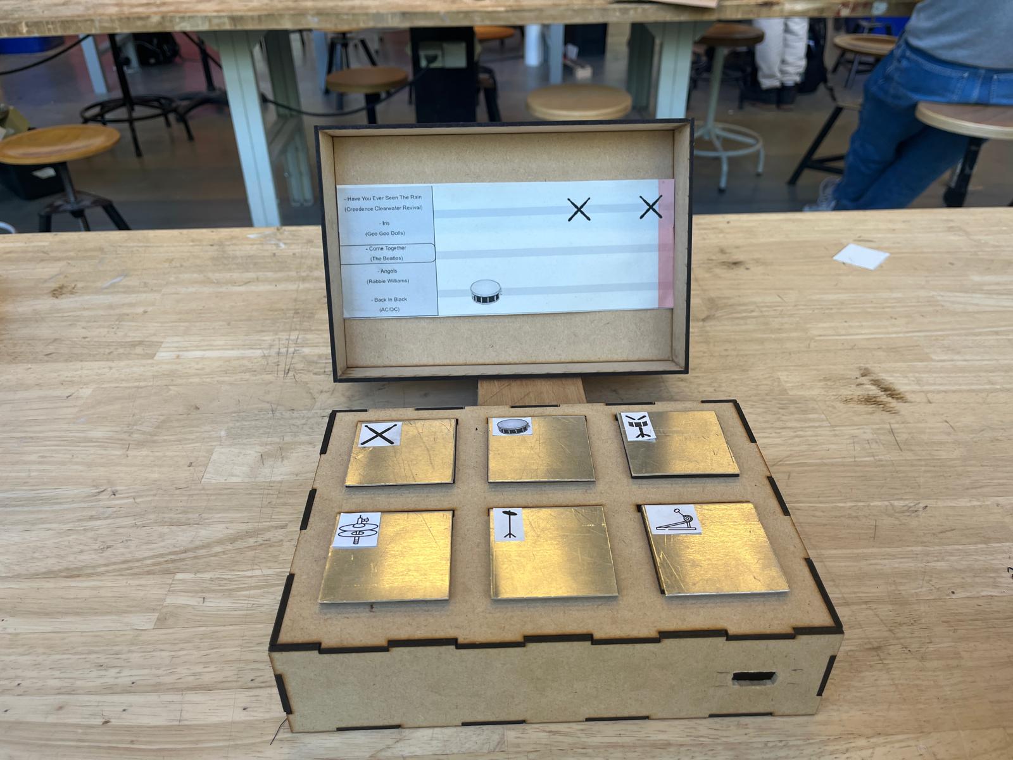
[picture p30: CYR PICS/BoomboxAanElkaar1.jpeg]
  
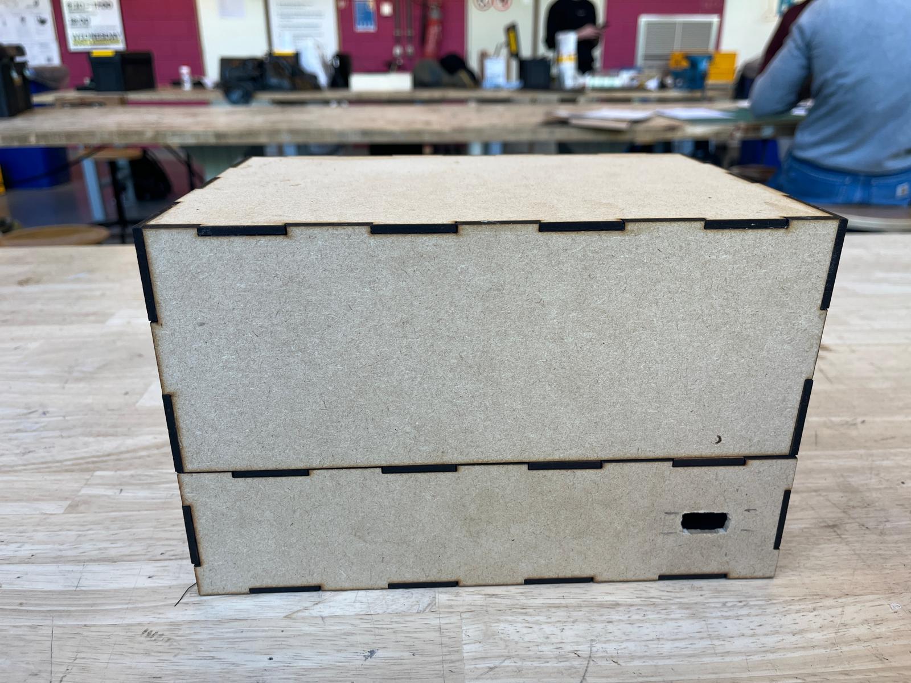
[picture p31: CYR PICS/BoomboxAanElkaar2.jpeg]
  

Binnen de boombox zal het scherm komen waar CYR kan gespeeld worden. Uit het rapport van [develop 1](https://ugentbe-my.sharepoint.com/:b:/g/personal/rosh_gryson_ugent_be/EcLrkE5KQL9KjGkvioypGBIBMkkocPpwzSfuyE07QG-s8w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) werd besloten dat de enkele draaiknop de beste manier was om liedjes te selecteren en te laten afspelen. Voor deze deelopdracht (4) wordt nog gewerkt met de originele boombox waar het scherm in zal geïntegreerd worden. Op de interface van de boombox zal de draaiknop (met voorlopige textuur en grootte) bevestigd worden en zal deze vorm variant gebruikt worden voor de eerst volgende testen. De keuze om verder te werken met de compactere iteratie ligt al vast en zal bij de finale deelopdracht gepresenteerd worden aan de gebruikers. Juist naar haalbaarheid en gebrek aan tijd wordt daarvoor nog de oudere variant van de boombox gebruikt voor deze testen. 

<p align="left">
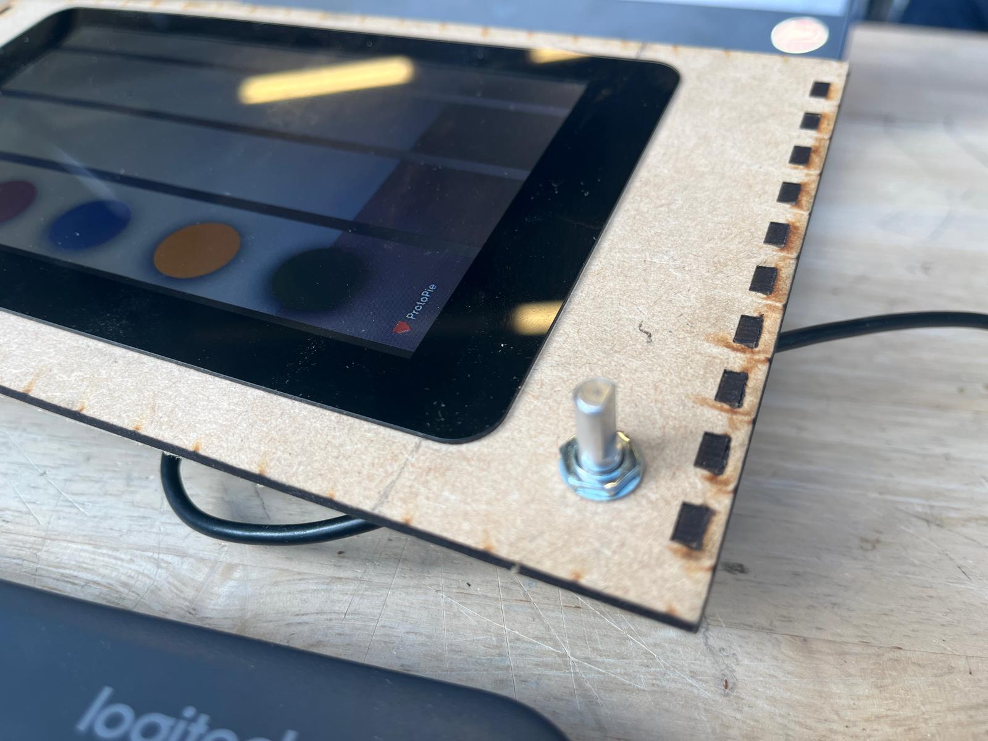
[picture p32: CYR PICS/CloseupDraaiknop.jpeg]
  
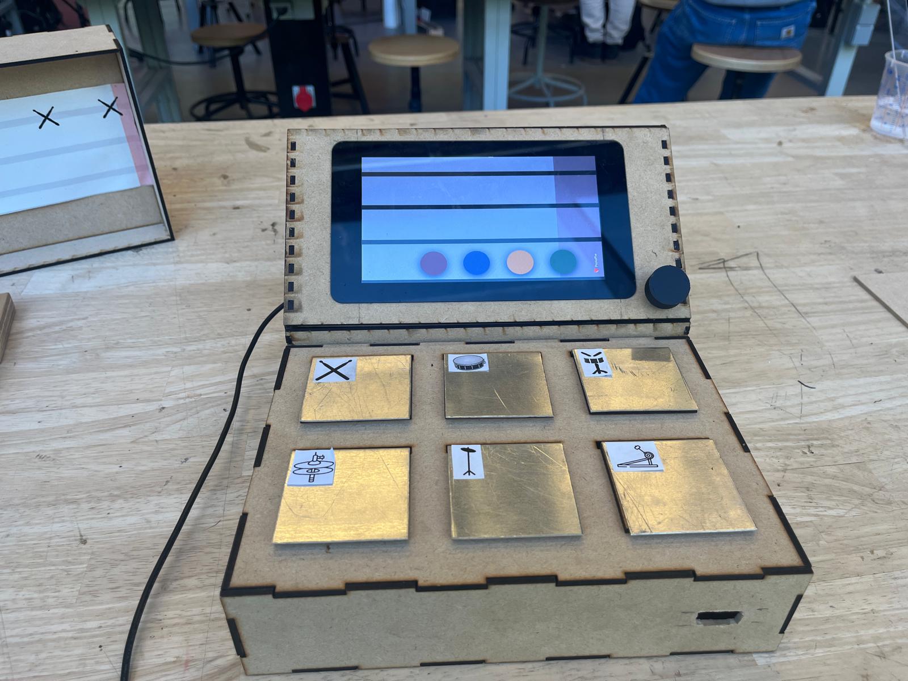
[picture p33: CYR PICS/BoomboxMetDraaiknop1.jpeg]
  
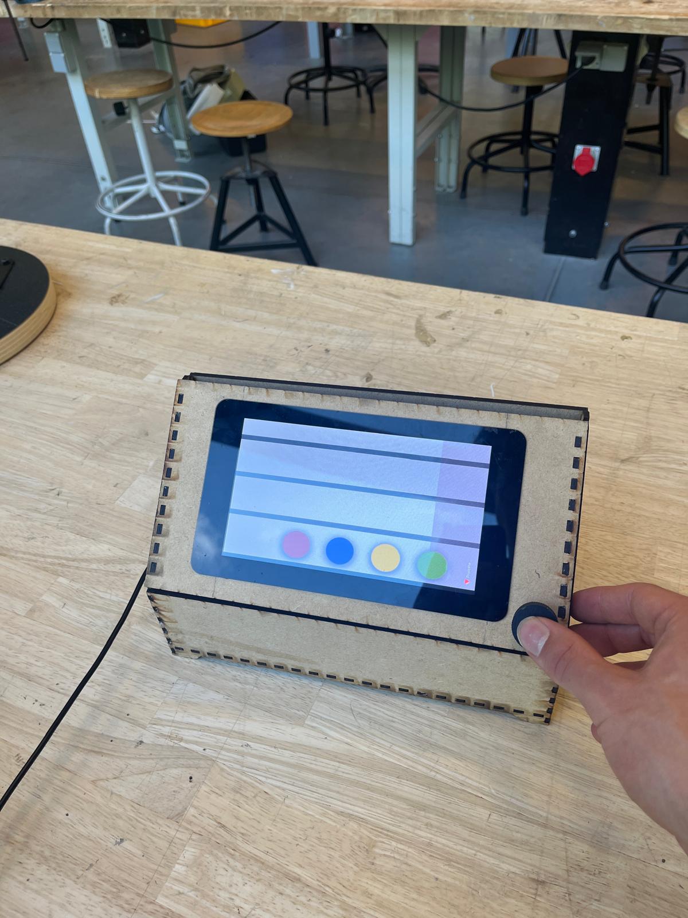
[picture p34: CYR PICS/BoomboxMetDraaiknop2.jpeg]
  

Het scherm en de interactie hiermee zijn gerealiseerd met de volgende technische componenten:
  - Raspberry Pi 4
  - Raspberry Pi 7" DSI Touchscreen display (800 x 480 px)
  - Arduino Nano
  - Rotary encoder
  - Gebruikte software:
    - Protopie
    - Protopie Connect
    - Arduino IDE

Zoals eerder vermeld, wordt het scherm in deze testfase geïntegreerd in de originele boombox. Het scherm is gekoppeld aan een Raspberry Pi 4 waarop Raspberry Pi OS als besturingssysteem draait.

Binnen Protopie is het spel aangepast om verschillende varianten van de huidige layout te testen. Hierbij wordt geëxperimenteerd met diverse lay-outs en de algemene uitstraling van het spel. Onderstaande foto's tonen vier verschillende spelvarianten.

<p align="middle">
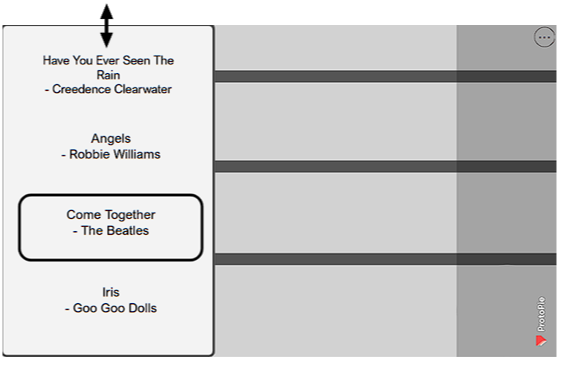
[picture p35: CYR PICS/Interface1.png]
  
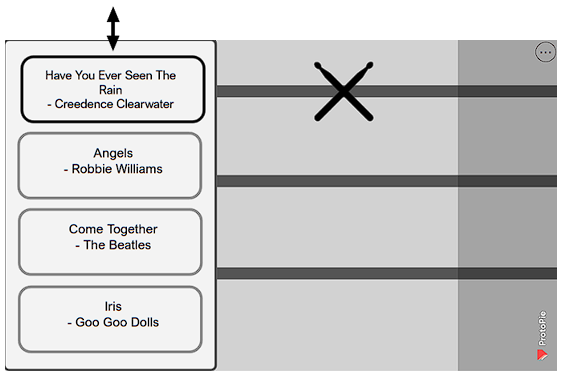
[picture p36: CYR PICS/Interface2.png]
  

<p align="middle">
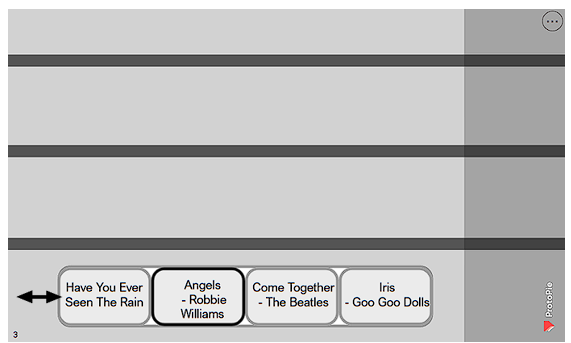
[picture p37: CYR PICS/Interface3.png]
  
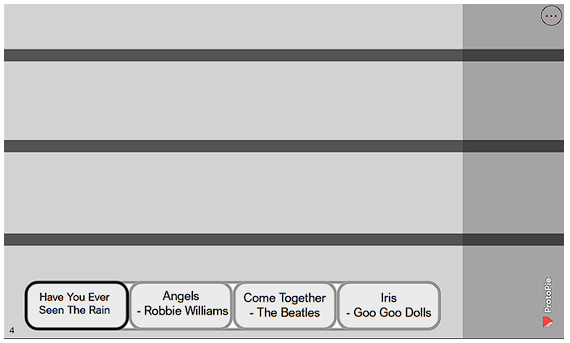
[picture p38: CYR PICS/Interface4.png]
  

De draai-/drukknop is gerealiseerd met behulp van een rotary encoder, aangesloten op een Arduino Nano. Deze knop ondersteunt meerdere interactiemogelijkheden:
- Een enkele klik
- Een dubbele klik
- Een draaibeweging (links:rechts)

Deze interacties sturen het bedieningsscherm van het spel aan en staan functioneel met elkaar in verband. De achterliggende code registreert het aantal rotaties naar links of rechts en bepaalt wanneer een signaal mag worden verstuurd. Bijvoorbeeld: een dubbele klik activeert het bedieningsscherm. Daarnaast wordt bijgehouden hoeveel keer er is gedraaid vóór een interactie wordt toegestaan. Zo ontstaat een gecontroleerde en intuïtieve besturing van het systeem.

> [!NOTE]
> De bijbehorende code is te raadplegen via volgende [link](./Code/Arduino/Code_Rotary_encoder). 

De verbinding tussen de Arduino Nano en Protopie verloopt via Protopie Connect. Door de laptop en de Raspberry Pi met hetzelfde netwerk te verbinden, kan in de webbrowser van de Raspberry Pi naar de juiste URL worden genavigeerd. Hierbij dient rekening gehouden te worden met het invoeren van het correcte IP-adres in de URL.

### Resultaten
De volgende resultaten komen rechtstreeks van het [rapport](https://ugentbe-my.sharepoint.com/:b:/g/personal/rosh_gryson_ugent_be/Ed8DPdIo2ZRFovkzM6mTZcQBQyfquAvjYD2CioEDKJAeWw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) en zullen hier kort toegelicht worden.

---

`Gebruiker 1:` Anne  <br>
`Gebruiker 2:` Marie-Paule <br>
`Gebruiker 3:` Jacques <br>
`Gebruiker 4:` Pieter Jan

---

#### **Touchbox MOS Test**
- 1 - zeer slecht
- 5 - uitstekend

|**Gebruiker** | **Score** | **Beperking**|
|-|-|-|
| Anne | 4 | Licht Storend | 
| Marie-Paule | 4-5 | Niet storend tot perfect|
| Jacques  | 4-5 | Niet storend tot perfect  |
| Pieter Jan  | /* | Geen mogelijke uitspraak  |
| | *Gem.: 4* ||

**<sub>Door omstandigheden werd de latency op de touchbox niet getest, hierdoor kon geen score/uitspraak gegeven worden.</sub>*

Hieruit kan geconludeerd worden dat zowel een verandering in software als hardware leiden tot een vermindering van de latency op de touchbox. 

#### **Texturen** 
- **<ins>X</ins>** - hoofdvoorkeur
- X - overige top 3

| | **Textuur 1** | **Textuur 2** | **Textuur 3** | **Textuur 4** | **Textuur 5** | **Textuur 6** |
|-|:---:|:---:|:---:|:---:|:---:|:---:|
| Anne | | | X | X | | **<ins>X</ins>** |
| Marie-Paule |  | | X | | X | **<ins>X</ins>** |
| Jacques  | | | X | | X |  **<ins>X</ins>** |
| Pieter Jan | X | | X | **<ins>X</ins>** | | ||

#### **Grootte van de draaiknoppen**
- **<ins>X</ins>** - hoofdvoorkeur
- X - overige top 3

| | **30mm** | **35mm** | **40mm** | **45mm** | **50mm** | **55mm** |
|-|:---:|:---:|:---:|:---:|:---:|:---:|
| Anne | **<ins>X</ins>** | X  | X | | | |
| Marie-Paule | **<ins>X</ins>** | X  | X | | | |
| Jacques  | | **<ins>X</ins>** | X | X | | |
| Pieter Jan | **<ins>X</ins>** | X  | X | | | ||

#### **Draaien van de knop** 
- **<ins>X</ins>** - hoofdvoorkeur

| | **2 clicks (1/8<sup>ste</sup> click** | **Kwartslag (5 clicks)** | **Halve omwenteling (10 clicks)** | **Volledige omwenteling (20 clicks)** | 
|-|:---:|:---:|:---:|:---:|
| Anne | **<ins>X</ins>** | | | | 
| Marie-Paule | **<ins>X</ins>** | | | | 
| Jacques  | **<ins>X</ins>** | | | | 
| Pieter Jan | **<ins>X</ins>** | | | | ||

#### **Design van het spel** 
- **<ins>X</ins>** - hoofdvoorkeur

| | **Design 1** | **Design 2** | **Design 3** | **Design 4** | 
|-|:---:|:---:|:---:|:---:|
| Anne | **<ins>X</ins>** | | | | 
| Marie-Paule | **<ins>X</ins>** | | | | 
| Jacques  | **<ins>X</ins>** | | | | 
| Pieter Jan | **<ins>X</ins>** | | | | ||

#### Een foto van Marie-Paule en Jacques tijdens een gebruikstest
<p align="left">
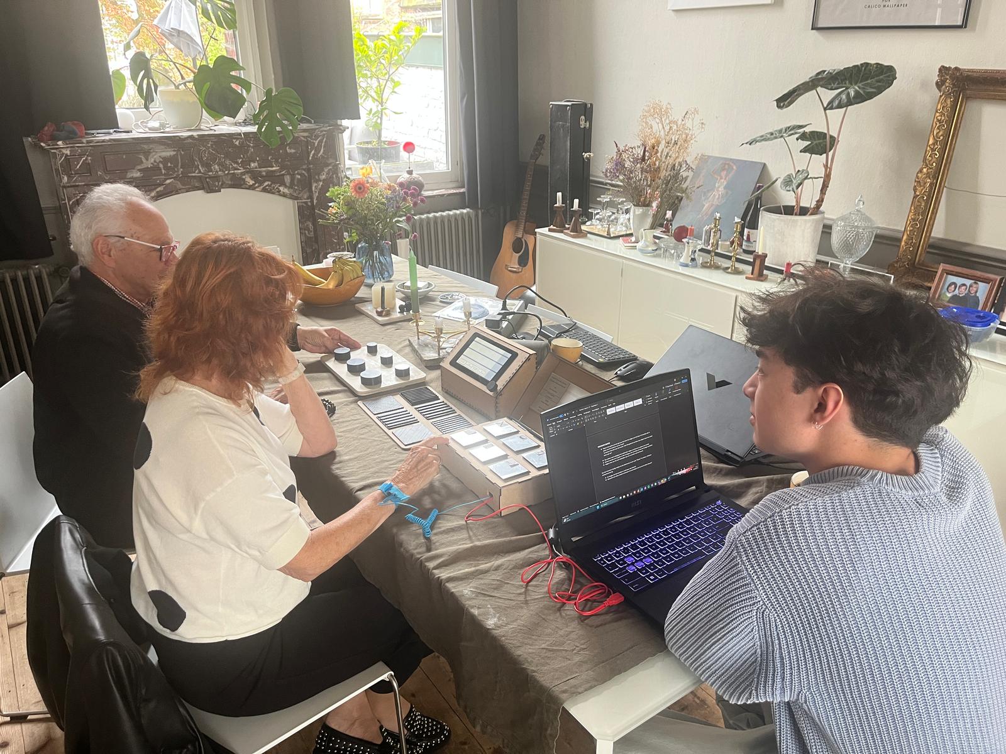
[picture p39: CYR PICS/TEST3.jpeg]
  

### Conclusies en implicaties

- De integratie van Arduino (in zijn geheel) als vervanger voor Makey Makey lijkt een positiever effect te hebben op de latency.
- Textuur 6 is de duidelijke winnaar voor de textuur die in de volgende deelopdracht zal geïntegreerd worden.
- Uit de tests blijkt dat elke gebruiker een voorkeur heeft voor de kleinere draaiknoppen. De draaiknop met een diameter van 30mm kreeg de hoofdvoorkeur.
- De tactiele feedback van de knop zal, volgens het rapport, verandert worden naar 2 clicks. Een groot deel van de gebruikers vond de _micro_ feedback na het aandraaien een fijn gevoel.
- Design 1 van de interface van de boombox werd unaniem verkozen als hoofdvoorkeur.
- Het uitvoeren van een dubbele klik werd door de gebruikers als lastig ervaren, deze handeling mislukte vaak tijdens de tests. Uit de feedback kwam naar voren dat een lange druk op de knop een gebruiksvriendelijker alternatief zou zijn. Dit aspect zal verder onderzocht worden in Develop 3.

> [!IMPORTANT]
> **Design requirements**
>  - 1.5 Het spel kan gespeeld worden zonder het dragen van een polsband.
>  - 1.6 De verbinding tussen de touchbox en boombox maakt het mogelijk deze op te bergen in één module.
>  - 2.6 De touchbox heeft een minimale hoogte, zodat de gebruiker het spel comfortabel kan blijven spelen zonder dat de arm vermoeid raakt.
>  - 4.6 De draaiknoppen bevatten textuur voor een betere gevoelservaring.
>  - 4.7 De draaiknop bevat tactiele feedback tijdens het aandraaien.

## Develop 3: Esthetische vormgeving (N=4)

### Doelstellingen
Deelopdracht 5 is de laatste deelopdracht van semester 2. In deze opdracht wordt de definitieve vormgeving van het prototype bepaald op basis van enkele functionele en esthetische aanpassingen. 

### Materialen & methoden 
Er wordt een finaal gebruikersonderzoek uitgevoerd naar de interactie met de drukknop, waarbij de ergonomie en feedback van de knop centraal staat. Daarnaast wordt de look & feel van het spel verder geëvalueerd, met specifieke aandacht voor de gebruikerservaring en visuele aantrekkelijkheid. Het integreren van de hendel (om ritme aan-/uit te zetten) in de spelinterface zal door tijdsgebrek niet meer lukken. Hierbij zal er enkel onderzoek gedaan worden naar het design van de hendel en welke vormgeving het beste toepast bij deze functie. <br>

#### Pygame

In vorige deelopdrachten werd vermeld dat de gebruikte software voor het opstarten van het spel geprogrammeerd werd m.b.v. Protopie. Een limitatie aan deze methode is het connecteren van het Raspberry Pi scherm naar de laptop met het in Protopie gemaakte spel. Een oplossing die hiervoor werd bedacht, was de introductie van Pygame. Dit biedt als voordeel dat het spel, geprogrammeerd in Pygame, kan opgestart worden zonder verbinding met een laptop. Ook zorgt het gebruik van Pygame ervoor dat er geen verbinding nodig is met een netwerk, een extra hulpmiddel om de tests soepeler te laten  verlopen. Het python script kan lokaal worden opgestart. De ontwikkeling en uitvoering van de code op de Raspberry Pi gebeurde met behulp van 'Geany Programmer's Editor'

> [!NOTE]
> De Python-code die werd geschreven voor het spelontwerp is [hier](Code/Python/Game_Design_Pygame/Game_Design_Pygame.ino) te raadplegen. Het bijhorende bedradingsschema vind je via deze [link](https://github.com/rooooosh/CYR/blob/Aging-Young/Emerging_Tech.md#opbouw-boombox).

#### Kleurenthema's en look van het product

Er is aanvullend onderzoek gedaan naar de kleurenthema’s en de algemene look & feel van het spel. Om een representatief beeld te krijgen van het gewenste thema voor CYR, zal een SAM-test worden uitgevoerd op basis van enkele bestaande populaire spellen. Hierbij werd gebruikgemaakt van onderstaand format:

<p align="left">
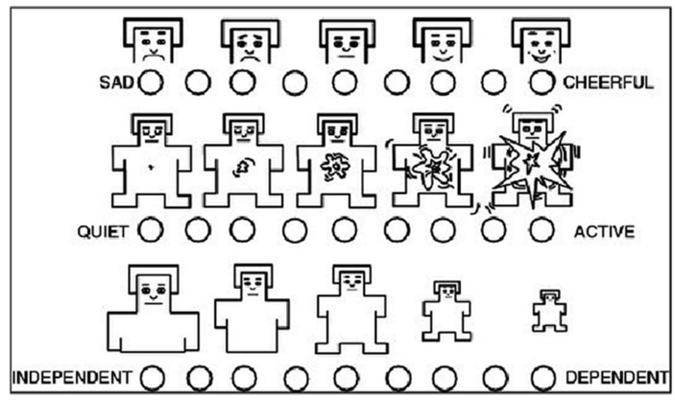
[picture p40: CYR PICS/SAM.png]
  

De gebruikers krijgen de opdracht om dit format in te vullen aan de hand van verschillende voorgestelde [thema’s](https://ugentbe-my.sharepoint.com/:b:/g/personal/rosh_gryson_ugent_be/EddukDsqnMFEonWV6gk9_9QBDJll5ITeB9r375OCDEYBWA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). Op deze manier werd inzicht verkregen in de voorkeuren met betrekking tot kleurgebruik, sfeer en visuele aantrekkelijkheid van het spel. De resultaten van deze test vormen een belangrijke leidraad voor de verdere uitwerking van het visuele ontwerp van CYR, zodat het eindproduct optimaal aansluit bij de beleving en verwachtingen van de doelgroep.

#### Design van integratie hendel in spelinterface

Aan de hand van volgend [document](https://ugentbe-my.sharepoint.com/:b:/g/personal/rosh_gryson_ugent_be/EXEy8T2KiR9CukrFr04W8asBibGEKA7jPmabWV9tvZJqBQ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) zal worden onderzocht welk ontwerp van de integratie van de hendel in de spelinterface door gebruikers als het duidelijkst en meest overzichtelijk wordt ervaren. In deze gebruikstest krijgen de deelnemers vier verschillende ontwerpvoorstellen te zien, elk met een unieke visuele en functionele benadering van de hendelintegratie.

Vervolgens worden de gebruikers gevraagd om elk ontwerp te beoordelen met een score van 1 (meest voorkeur) tot 4 (minst voorkeur). Tijdens de test zal actief worden gevraagd naar de motivatie achter hun keuzes om onderliggende redenen en eventuele suggesties voor verbetering te noteren. Na afloop van de test zal de feedback omgebuigd worden naar de behoeften van de doelgroep om aspecten zoals duidelijkheid, gebruiksgemak en visuele hiërarchie grondig vast te leggen in het eindontwerp van CYR.

#### Esthetische vormverandering
Tot nu toe is het ontwerp van CYR voornamelijk functioneel benaderd, waarbij het esthetische aspect eerder in het achterhoofd bleef zitten. In deze fase werd het belangrijk om ook op het vlak van vormgeving verdere stappen te zetten. Er is gekozen om de algemene uitstraling van CYR zwart te maken. Deze kleur vormt een neutrale en tijdloze keuze die geschikt is voor een breed doelpubliek.

<p align="left">
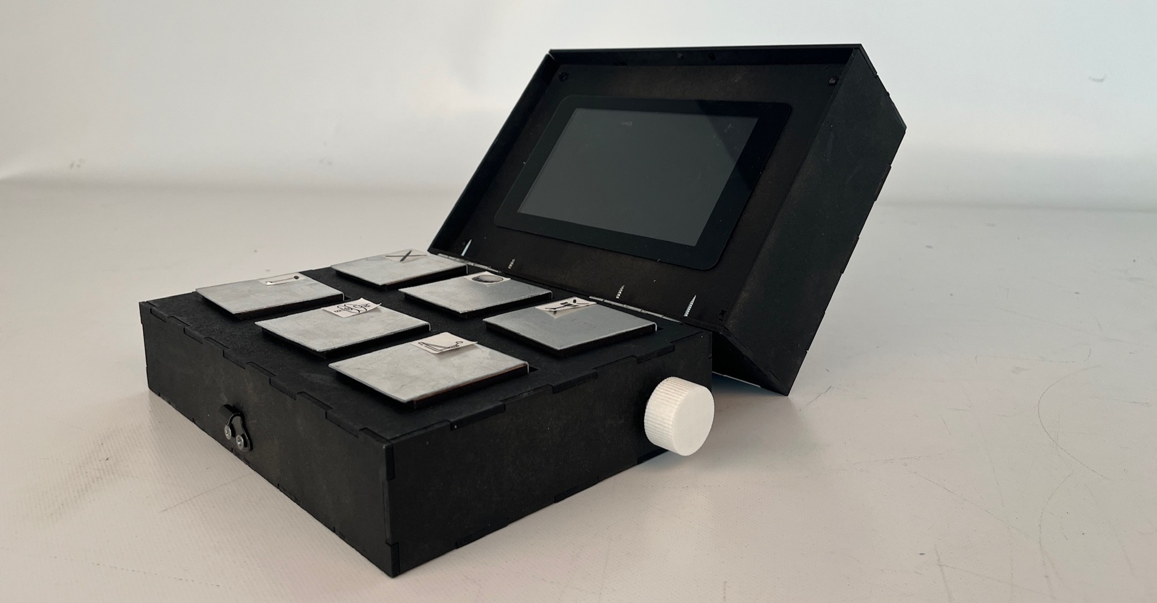
[picture p41: CYR PICS/Gespoten_Doos.jpg]
  

***Overweging Extra kleurelement***

  Bij het ontwerp werd overwogen om een extra kleurelement toe te voegen. Op basis van Plutchik's 'Wheel of Emotion' werd een gele tint als passend beschouwd voor zowel het ontwerp als de doelgroep. Uiteindelijk is ervoor gekozen dit kleurelement niet te integreren in het prototype, omdat de kleurkeuze nauw moet aansluiten bij het onderzoek naar de kleurenthema's van het spel. Dit onderzoek heeft immers een grote invloed op de samenhang tussen de visuele elementen en het uiteindelijke ontwerp. Hieronder is een moodboard te zien over de gele tint, waarmee er in een later proces verder gewerkt zou kunnen worden

<p align="left">
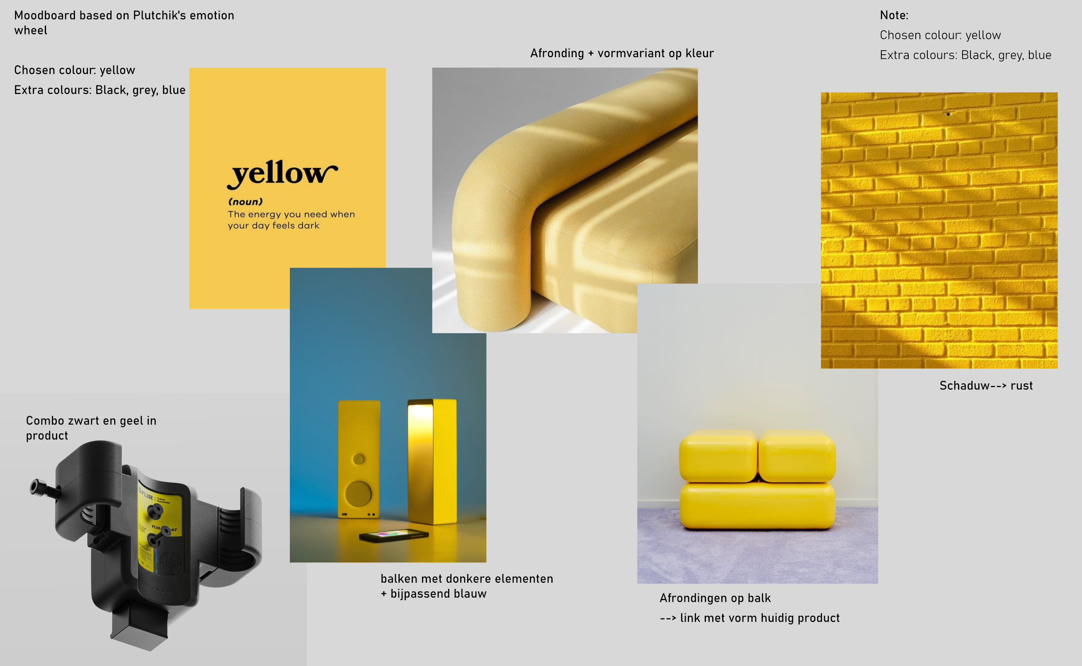
[picture p42: CYR PICS/Moodboard Putchik.jpg]


#### Toevoeging ondersteuningshendel
Door toegenomen gewicht van het prototype (medemogelijk door integratie Raspberry Pi scherm) zal aan de bovenkant van het ontwerp een ondersteuningshendel worden voorzien om dit geheel stabiel te houden. Daarbij aansluitend zal een extra functionaliteit voorzien worden waarbij de hendel fungeert als handvat, dit zal in deze deelopdracht getest worden.

<p align="left">
  
  

#### Kliksysteem
 Een kliksysteem wordt geïntroduceerd aan het prototype zodat deze niet opeens zou openspringen, dit zal onderworpen worden aan een praktische test. Ook worden een aantal verschillende variaties op dit kliksysteem voorgelegd aan de gebruiker. Bij deze een keuze te maken welk kliksysteem volgens hun vermoeden een beter of slechter alternatief kan zijn dan het standaard gemonteerde systeem.

_Foto 1: Standaard kliksysteem; Foto 2: Kliksysteem variant 1; Foto 3: Kliksysteem variant 2; Foto 4: Kliksysteem variant 3; Foto 5: Kliksysteem variant 4_
<p align="left">
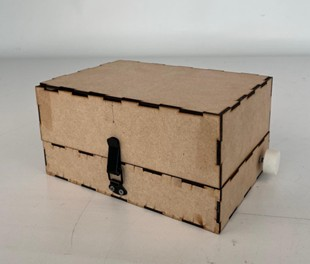
[picture p45: CYR PICS/Sluiting.jpg]
  
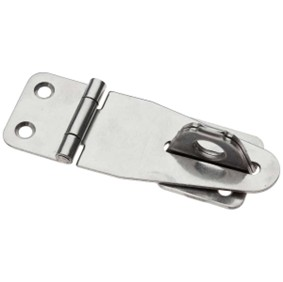
[picture p46: CYR PICS/Klik1.jpg]
  
<p align="left">
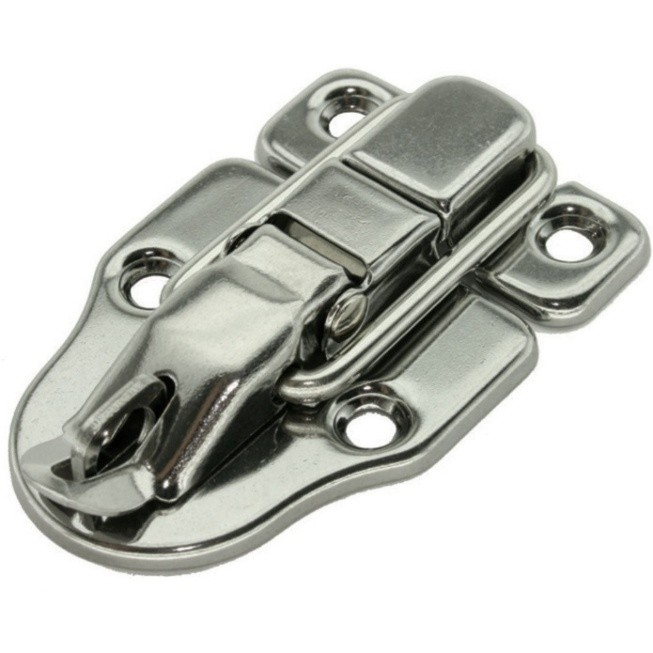
[picture p47: CYR PICS/Klik2.jpg]
  
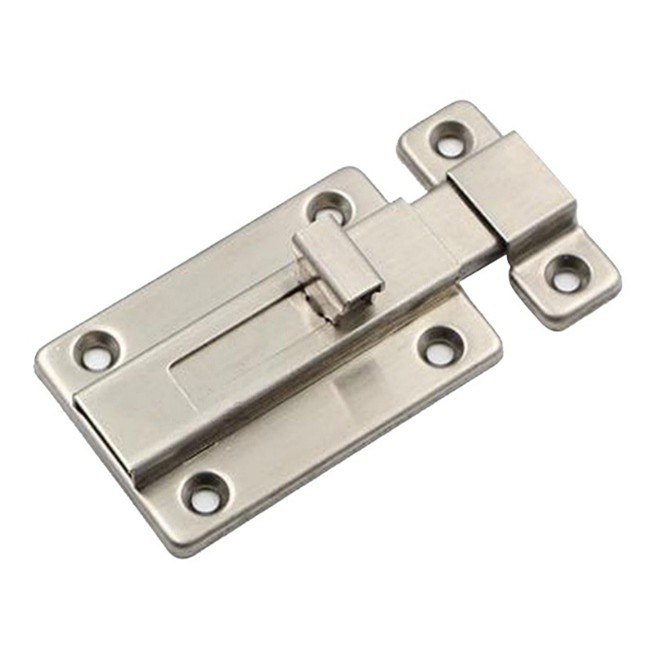
[picture p48: CYR PICS/Klik3.jpg]
  
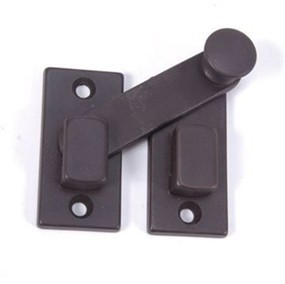
[picture p49: CYR PICS/Klik4.jpg]
  

> [!IMPORTANT]
> Verdere ontwerpkeuzes worden toegelicht in [Protocol develop 3](https://ugentbe-my.sharepoint.com/:b:/g/personal/rosh_gryson_ugent_be/EXTqkAN2p1pOgIOTG9bTYhYB0weaJiqkyBv4y06PXGTpgw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).

### Resultaten
De volgende resultaten komen rechtstreeks van het [rapport](https://ugentbe-my.sharepoint.com/:b:/g/personal/rosh_gryson_ugent_be/EfC592EW2ZVPsl3D-SPsxN4BTB7b4cqZrUNqIZX2eIkBWg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) en zullen hier kort toegelicht worden.

---

`Gebruiker 1:` Pieter Jan <br>
`Gebruiker 2:` Anne <br>
`Gebruiker 3:` Marie-Paule <br>
`Gebruiker 4:` Jacques

---

#### Long press voor selectiescherm 
- **<ins>X</ins>** - hoofdvoorkeur

| | **750ms** | **1000ms** | **1500ms (standaard)** | **Eigen voorstel? (optioneel)** | 
|-|:---:|:---:|:---:|:---:|
| Pieter Jan |  **<ins>X</ins>** | | | | 
| Anne |  **<ins>X</ins>**| | | | 
| Marie-Paule  | **<ins>X</ins>** | | |  500ms |
| Jacques | **<ins>X</ins>** | | |  500ms  |

De meningen over de duur van de drukknop waren verdeeld. Alle gebruikers vonden 1500ms te lang, dit gaf snel de indruk dat er iets mis was of dat het apparaat niet reageerde. Een duur van 750ms werd over het algemeen als beter ervaren, al gaven Marie-Paule en Jacques aan dat het voor hen nog iets korter mocht (500ms). Tijdens de tests bleek er soms verwarring te ontstaan tussen een enkele klik en een lange klik bij 500ms. Daarom is gekozen om 750ms als standaard indruktijd te integreren in het product.

#### Kleurenthema's en look product 

De resultaten van de SAM-test zijn [hier](https://ugentbe-my.sharepoint.com/:b:/g/personal/aldo_vanhese_ugent_be/EVC1BHvYk0pLt7RclKCJMEIB6Pc4BeH628hsrbDKr_4vAQ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) terug te vinden. De belangrijkste gegevens worden hieronder nog even bij elkaar gezet. Item 3 op de SAM-test (dependent/independent) was voor veel gebruikers niet direct duidelijk. Hiermee werd bedoeld hoe goed het spel op zichzelf staat, m.a.w. in welke mate is dit een kwalitatief, volledig spel.

  - **Piano Tiles**
    - Piano Tiles werd op basis van gevoel eerder neutraal tot cheerful geëvalueerd.
    - Op vlak van drukte werd er een neutrale score gegeven.
    - Op vlak van dependent/independent werd er een neutrale score gegeven.
  - **Guitar Hero**
    - Guitar Hero kreeg een eerder 'cheerful', dus positievere score.
    - Voor velen werd dit ontwerp als vrij druk geëvalueerd.
    - Op vlak van dependent/independent werd er een neutrale-cheerful score gegeven.
  - **Jewel Saga**
    - De meningen over dit thema waren sterk verdeeld. Mogelijk komt dit doordat sommige gebruikers het spel al kenden, waardoor zij al dan niet een voorkeur hadden voor het ontwerp en er dus sprake was van een zekere bias.
    - Jewel Saga kreeg een neutrale-quiet evaluatie.
    - Er werd op vlak van independent/dependent een redelijk hoge 'dependent' score gegeven.
  - **Just Dance**
    - Just Dance kreeg een zeer cheerful score.
    - Op vlak van drukte kreeg deze een zeer drukke score.
    - Op één uitzondering na, kreeg deze een vrij hoge score op vlak van onafhankelijkheid.
  - **Eigen Ontwerp**
    - Het eigen ontwerp kreeg een zeer hoge score op vlak van emotie. 
    - Het kreeg op basis van drukte een eerder neutrale score.
    - Op vlak van independent/dependent kreeg deze een zeer hoge 'dependent' score.

#### Design van integratie hendel in spelinterface
- 1 - meest voorkeur
- 4 - minst voorkeur

| | **Design 1** | **Design 2** | **Design 3** | **Design 4** | 
|-|:---:|:---:|:---:|:---:|
| Pieter Jan |  2 |  4 | 3 | 1 | 
| Anne |  2 |  3 |  4 | 1 | 
| Marie-Paule  | 3 |  2 | 1 |  4 | 
| Jacques | 2 | 4 | 1 | 3  |

#### Toevoeging ondersteuningselement
De algemene mening rond de toevoeging van het ondersteuningselement leek een logiche zaak. Er werd vol begrip akkoord gegaan met het integreren van deze functie in het prototype om het plotseling omvallen te voorkomen. De dubbelfunctie rond het gebruik van deze ondersteuning als handvat werd gezien als mooie ingeving. De gebruikers kunnen op hun beurt gemakkelijk het prototype verplaatsen van A naar B via dit _handvat_. In de toekomst kan ingestemd worden voor een verdeelde keuze rond het design van dit element, maar conceptueel gezien is dit een positieve toevoeging aan het prototype.

#### Ranking Kliksysteem
- **<ins>X</ins>** - hoofdvoorkeur
- X - overige top 3

| | **Systeem 1** | **Systeem 2** | **Systeem 3** | **Systeem 4** | **Systeem 5 (standaard)** | 
|-|:---:|:---:|:---:|:---:|:---:|
| Pieter Jan | | | | |  **<ins>X</ins>**  | 
| Anne | | |  X | **<ins>X</ins>** |  X  | 
| Marie-Paule  | X | X | **<ins>X</ins>** | | | | 
| Jacques | X | X | **<ins>X</ins>** | | | |

### Conclusies en implicaties
- Een korte duratie van de long press voor het tevoorschijn halen van het selectiescherm kreeg de voorkeur van alle gebruikers.
- Verdeelde meningen werden bevonden uit de SAM-testen wat betreft look & feel van het spel. In de toekomst kan in het spelinterface een optie geprogrammeerd worden waarbij de gebruiker een keuze kan maken uit deze designs i.p.v. een enkele keuze.
- Rond het design van de hendel werden design 1 en design 4 bij voorkeur genomen. Dit mede door de betere intuïtie ervaren bij dit ontwerp.
- Het ondersteuningselement is een logisch gegeven en een terechte toevoeging. De extra functie als handvat is een positieve bijzaak en kan ook richting de toekomst veranderen in vormgeving en functionaliteit.
- De toevoeging van het kliksysteem is een logisch gegeven. Er werd bij alle gebruikers aangekaart dat deze handeling niet te complex mag zijn. Dit mechanisme bedienen met één hand was de hoogste prioriteit tijdens de testen.
- De gebruikers hadden een positieve mening rond de nieuwe vormgeving van CYR. Het straalt meer professionalisme uit en geeft meer motivatie om het spel te spelen.
- De integratie van de geluidsversterkende componenten aangehaald in het protocol, werden niet meer geïntegreerd in het ontwerp. Dit mede door de complexiteit met de te verbinden componenten en de verminderde audiokwaliteit na aansluiting met de MP3.

> [!IMPORTANT]
> **Design requirements**
>  - 1.7 De ondersteuningshendel moet makkelijk inzetbaar zijn.
>  - 1.8 Het sluitingsmechanisme moet met één hand worden bediend.

## Algemene conclusie

### Slotbevindingen

De verschillende deelopdrachten (3, 4 en 5) brachten telkens nieuwe frisse ontwerpuitdagingen aan het licht na de introductie van de verbeterde prototypes. Er werd telkens positieve progressie gemaakt richting het eindontwerp waarbij de gebruikers zeer nuttige en goed onderbouwde feedback gaven. 

Tijdens het project werd een iteratief ontwerpproces doorlopen. In de discovery fase zijn de noden van mensen met de ziekte van Parkinson onderzocht via literatuurstudies en interviews, wat leidde tot het initiële concept van CYR. In de definition fase zijn de eerste prototypes van de touchbox en boombox ontwikkeld en getest met gebruikers. Op basis van feedback zijn de benodigde aanpassingen geleverd aan de verschillende gebruiksinterfaces en interacties, zoals het verminderen van het aantal toetsen en het toevoegen van duidelijke iconen.

In de develop fase lag de focus op het verfijnen van ergonomie, gebruiksvriendelijkheid en esthetiek. Makey Makey werd vervangen door Arduino om de latency te verbeteren, een draaiknop werd geïntroduceerd voor intuïtieve bediening en er werd een complete vormverandering van CYR geïntroduceerd. Verschillende iteraties zijn getest waarbij gebruikers voorkeuren aangaven voor texturen, knopgrootte en interface-layout. Het prototype is compacter gemaakt door integratie van touchbox en boombox en een ondersteuningspoot is toegevoegd voor stabiliteit.

Tot slot is het visuele ontwerp verder uitgewerkt met aandacht voor kleurenthema’s en een gebruiksvriendelijk kliksysteem. Elke stap is onderbouwd door gebruikersfeedback waardoor het eindproduct optimaal aansluit bij de behoeften van de doelgroep en de gestelde eisen aan het begin van het project.

#### Toekomst gerichte verbeteringen CYR

Zelfs naar einde van het project werden opnieuw nieuwe zaken aan het licht gebracht die het prototype kunnen brengen naar een volgend niveau. Deze zaken zullen uiteraard niet meer behandeld worden (wegens tijdsgebrek), maar zullen hieronder weergegeven worden als een bullet list met zaken die in de toekomst kunnen toegevoegd worden: 

- Programmeren van hendel in spelinterface
- Laten oplichten van toetsen in verschillende kleur voor extra moeilijkheid
- Toevoegen van moeilijkheidsniveau's 
- Compacter maken van prototype
- Spel spelen zonder bedrading en aansluiting met laptop (uiteraard)
- Eigen liedjes in het spel steken
- Keuze uit verschillende spelthema's tijdens spelen van het spel

Deze lijst is niet limiterend en kan in de toekomst nog aangevuld worden. Bovenstaande zaken werden vaak aangekaart door de gebruikers tijdens het jaar door.

#### PESTLE-analyse CYR

Een PESTLE-analyse onderzoekt de externe factoren die invloed kunnen hebben op een product of dienst. Voor CYR helpt deze analyse om inzicht te krijgen in de bredere context waarin het ontwerp zich bevindt en waar het eventueel in de toekomst kan bevinden. Hieronder worden de zes domeinen toegelicht, telkens aan de hand van een relevante vraag:

- **1. Politiek**
  > Zijn er overheidsmaatregelen of subsidies die het gebruik van CYR voor Parkinson patiënten zouden ondersteunen?

- **2. Economisch**
  > Hoe beïnvloeden economische factoren zoals de kostprijs van componenten en productie de haalbaarheid van CYR?

- **3. Sociaal**
  > In hoeverre sluit het product aan bij de sociale noden van Parkinson patiënten en hun omgeving?

- **4. Technologisch**
  > Welke technologische innovaties kunnen de functionaliteit of gebruikerservaring van CYR versterken?

- **5. Legaal**
  > Zijn er relevante wet -en regelgevingen rond medische hulpmiddelen die van invloed zijn op CYR?

- **6. Ecologisch**
  > Kan het ontwerp aangepast worden om de ecologische voetafdruk te verkleinen?

Door deze factoren van bij het begin in het ontwerp -en ontwikkelproces te integreren, verhoogt de kans dat CYR niet alleen technisch functioneel is, maar ook maatschappelijk relevant, wettelijk conform en duurzaam in gebruik. Deze analyse vormt dan ook een essentiële basis voor verdere besluitvorming en strategische keuzes binnen het project.

### Finale design requirements

| ID | Design requirement | Source | Date |
| --- | --- | --- | --- |
| **D1**  | **Algemeen** |  |  |
| D1.1 | De touchbox bevat een minimale hoogte om elektronica te bewaren. | Discovery | 14/11/2024 |
| D1.2 | De boombox bevat een minimale grootte voor het ondersteunen van een scherm. | Definition | 5/12/2025 |
| D1.3 | De touchbox en boombox bevatten snap/klikverbindingen om deze aan/uit elkaar te halen. | Develop 1 | 3/03/2025 |
| D1.4 | Het product is zo compact mogelijk. | Develop 1 | 3/03/2025 |
| D1.5 | Het spel kan gespeeld worden zonder het dragen van een polsband. | Develop 2 | 16/04/2025 |
| D1.6 | De verbinding tussen de touchbox en boombox maakt het mogelijk deze op te bergen in één module. | Develop 2 | 16/04/2025 |
| D1.7 | De ondersteuningshendel moet makkelijk inzetbaar zijn. | Develop 3 | 19/05/2025 |
| D1.8 | Het sluitingsmechanisme moet met één hand worden bediend. | Develop 3 | 19/05/2025 |
| **D2**  | **Gebruiksgemak** |  |  |
| D2.1 | De touchbox produceert geluid door een enkele aanraking met één van de toetsen. | Discovery | 14/11/2024 |
| D2.2 | Het indrukken van de knoppen op de touchbox gebeurt aan de hand van capacitive touch. | Definition | 5/12/2025 |
| D2.3 | Elke toets wordt afgebeeld met een ander symbool. | Definition: Wave 1 | 5/12/2024 |
| D2.4 | De interface van de boombox is ontworpen zonder overbodige elementen, zodat de interactie eenvoudig blijft. | Develop 1 | 3/03/2025 |
| D2.5 | Voor elke gebruiker is een uitdagend niveau beschikbaar. | Develop 1 | 3/03/2025 |
| D2.6 | De touchbox heeft een minimale hoogte, zodat de gebruiker het spel comfortabel kan blijven spelen zonder dat de arm vermoeid raakt. | Develop 2 | 16/04/2025 |
| **D3** | **Interactiviteit** |  |  |
| D3.1 | De boombox heeft een functieknop aan de zijkant om het ritme van muziek aan/uit te schakelen. | Discovery | 24/10/2024 |
| D3.2 | De boombox bevat verschillende knoppen om een keuze te maken uit verschillende liedjes. | Discovery | 24/10/2024 |
| D3.3 | Het product maakt duidelijk met welke elementen de gebruiker kan interageren. | Develop 1 | 3/03/2025 |
| D3.4 | De touchbox is responsief en heeft een lage latency. | Develop 1 | 3/03/2025 |
| D3.5 | De hendel moet niet fysiek aanwezig zijn op de boombox. | Develop 1| 3/03/2025 |
| **D4** | **Ergonomie** |  |  |
| D4.1 | De dimensies van de touchbox (25,5cm x 17,5cm) maken het mogelijk deze makkelijk op te bergen.  | Discovery | 24/10/2024 |
| D4.2 | De drukknoppen hebben een minimale diameter van 4-6cm om een keuze uit liedjes te maken. | Discovery | 24/10/2024 |
| D4.3 | De toetsen bevinden zich in een dicht gestapeld raster (2x2, 3x2, 3x3) om multi-touch mogelijk te maken. | Discovery | 24/10/2024 |
| D4.4 | De knoppen van de touchbox bevatten een grootte van 6x6cm. | Develop 1 | 3/03/2025 |
| D4.5 | De interactie met de boombox gebeurt aan de hand van fysieke knoppen. | Develop 1 | 3/03/2025 |
| D4.6 | De draaiknop bevat textuur voor een betere gevoelservaring. | Develop 2 | 16/04/2025 |
| D4.7 | De draaiknop bevat tactiele feedback tijdens het aandraaien. | Develop 2 | 16/04/2025 |

## Kritische reflectie
$$Rösh:$$

"Ik vond dat semester 1 vooral zoeken was naar een goede methodologie die we konden volgen voor de rest van het jaar. Tijdens de presentatie op het eind van semester 1 werden een aantal zaken aangehaald die we beter konden uitvoeren zoals het opstellen van functionele design requirements. Deze kritiek hebben we geprobeerd om te buigen naar een meer positievere aanpak bij aanvang van het tweede semester. Een groot struikelblok bleek toch het contacteren van mensen die pasten binnen onze doelgroep. Een aantal van onze contactpersonen waarmee wij getest hadden, werden opeens moeilijker te contacteren waarbij dit uiteindelijk resulteerde in het contacteren van nieuwe testpersonen. Dit was iets dat wij niet op voorzien waren, dus was dit een extra uitdaging om nieuwe gebruikers aan te trekken. 

Wat betreft het prototype is er veel progressie gemaakt. De stappen die werden genomen naar aanleiding van het eindprototype zijn kritisch onderbouwd en ook goed gecommuniceerd met de gebruikers. Het spel kreeg voortdurend positieve feedback en de gebruikers bleven enthousiast bij de volgende progressie die werd gemaakt. Als conclusie kan ik zeggen dat het project geslaagd is. Natuurlijk is er véél ruimte om het prototype te verbeteren, maar voor de tijd die wij ter beschikking kregen, vind ik dat we het maximale eruit gehaald hebben."

$$Aldo:$$

"Semester 1 was vooral een zoektocht naar de juiste aanpak voor ons project. We hebben verschillende methodes uitgeprobeerd, wat soms leidde tot een wat chaotische werkwijze, bijvoorbeeld bij het contacteren van gebruikers en het vastleggen van het concept. Toch leverde deze fase veelbelovende resultaten op en bevestigde het de waarde van ons idee. Dit gaf ons de motivatie om in semester 2 met een meer gestructureerde aanpak verder te werken aan het project.

In semester 2 hebben we geprobeerd om de valkuilen uit semester 1 te vermijden, zoals het tijdig contacteren van alle testpersonen. Door de specifieke doelgroep bleef dit echter een uitdaging, waardoor we in één van de develop-fases met één testpersoon minder moesten werken dan gepland. Nadien hebben we gelukkig nieuwe testpersonen gevonden die bereid waren om meerdere keren deel te nemen aan de tests. Over het algemeen ben ik tevreden over onze aanpak en inzet binnen het project. We hebben goed samengewerkt en zijn erin geslaagd om tot een werkend prototype en concept te komen."

## Technische beschrijving
### Finale Bill Of Materials (BOM)

| Nr. |  Component  |Aantal|Opmerkingen| Geschatte Kostprijs|
|-----|-----|-----|-----|-----|
|$1$|  MDF-platen  |5|Gebruikte platen 450x600mm|€10|
|$2$| Gebogen aluminiumplaten  |6| Basisafmetingen 6x6, extra buiging voor verbinding krokodillenklemmen|€3|
|$3$|  Scharnieren  |2||€6|
|$4$| Latch  | 1||€3
|$5$| Bouten | 12| Op huidige prototype zitten er ook vijzen in, functionaliteit blijft hetzelfde bij bouten, maar qua kost net iets hoger| €9,50|
|$6$| Moeren | 12||Inbegrepen bij Nr. $5$|
|$7$|Velcro-strips|1||€5|
|$8$| Strip stof | 2 |Verbinding ondersteuningspoot| €0,50|
|$9$| Houten balken|3| Ondersteuningspoot | €3|
|$10$| Raspberry Pi 4|1||€62,30|
|$11$| Raspberry Pi 7" DSI Touchscreen display |1|800 x 480 px|€89,50|
|$12$|Rotary encoder|1||€3,50|
|$13$| 3DP draai/drukknop|1| PLA| €0,50|
|$14$| Arduino Nano| 2 || €27,10|
|$15$| Krokodillenklemmen|6|| €3,99|
|$16$| Breadboard en jumper wires |1 set| Kan in gezamenlijk pakket aangekocht worden |€5-€10|
|$17$| 12 Key Capacitive I2C Touch Sensor |1|MPR121| €8,94|
|$18$|DFplayer Mini|1|MP3-TF-16P V3.0| €5,99|
|$19$|Micro-SD kaart|1|| €6
|$20$|Weerstand|1|1,2kΩ| €0,60|
|$21$|Speaker|1 | 3W - 5Ω|€3,99|
|$22$|Bleutooth Speaker|1||€5-€20
|$23$|USB-A Kabels |2|| Inbegrepen bij Nr. $14$

### Bouwmaterialen

Het prototype bevat een aantal standaardmaterialen waarbij deze na een aantal nabewerkingsstappen werden omgevormd tot de finale vormgeving van CYR. De hoofdmaterialen die zijn gebruikt:

- MDF met dikte 3mm
- Aluminiumplaten met dikte 2-3mm

Het design van de touchbox en boombox doos stamt af van een online ontwerp afkomstig van volgende website: [Boxes.py | Hackaday.io](https://hackaday.io/project/10649-boxespy)

De afmetingen van beide dozen bedragen:

- **Toucbox**: 255mm x 176mm x 60mm
- **Boombox**: 255mm x 176mm x 75mm

Volgende dimensies kunnen ingevoerd worden in bovenstaande vermelde website en kunnen vervolgens gedownload worden in volgende formaten: svg, dxf, gcode, lbrn2, pdf, plt, ps, svg, svg_Ponoko

Via een lasercut programma (dit geval [Lightburn](https://lightburnsoftware.com/)) kan volgend bestand in een workspace upgeload worden en vervolgens gesneden worden volgens de ingevoerde dimensies van de doos.

---

### Elektronica en Arduino componenten
De volgende elektronica/Arduino componenten worden gebruikt om de huidige communicatie van het spel te realiseren. Meer informatie hierover is [hier](https://github.com/rooooosh/CYR/blob/Aging-Young/Emerging_Tech.md#eindopdracht-emerging-technologies) terug te vinden.
 Deze worden opgesplitst per gebruikte componenten voor touchbox en boombox:

**Touchbox**

- Arduino Nano 
- 12 Key Capacitive I2C Touch Sensor (MPR121)
- MP3-TF-16P V3.0 (DF player mini)
- Weerstand 1,2kΩ
- Speaker 3W - 5Ω

Extra onderdelen die werden aangekocht, maar uiteindelijk niet verwerkt in het eindprototype:

- [PAM8403](https://www.amazon.com.be/dp/B07DJWGQVY?ref=ppx_yo2ov_dt_b_fed_asin_title)
- [Speaker 5W - 8Ω](https://www.amazon.com.be/dp/B0C7PJ5XZZ?ref=ppx_yo2ov_dt_b_fed_asin_title)
- [TPA 3110](https://www.amazon.com.be/dp/B07DK51R75?ref=ppx_yo2ov_dt_b_fed_asin_title)

> [!NOTE]
> De **PAM8403** en **TPA3110** worden beiden gelabeld als geluidsversterkende componenten (EN: amplifiers), maar door de complexiteit van de bedrading en minder resultaat na aansluiting met de Arduino werden deze niet meer geïntegreerd in het ontwerp.

**Boombox**

- Raspberry Pi 4
- Raspberry Pi 7" DSI Touchscreen display (800 x 480 px)
- Rotary Encoder
- Arduino Nano
- Bluetooth Speaker

De gebruiker bedient het scherm via de rotary encoder, waarbij seriële communicatie plaatsvindt tussen de Raspberry Pi en Arduino. Hoewel directe aansluiting van de rotary encoder op de Raspberry Pi mogelijk is, was de Arduino-code al geschreven voordat werd gekozen om met Python te werken, door tijdsgebrek (en volledig functionele werking), is deze aanpassing niet gebeurt.

## Bijlagen

De verzamelde respondentgegevens zijn enkel toegankelijk voor personen binnen de UGent, om hun privacy zo goed mogelijk te beschermen.

**Deelopdracht 1: Discovery** 
- [Protocol interviews](https://ugentbe-my.sharepoint.com/:b:/g/personal/rosh_gryson_ugent_be/EYx5H9Q-MfJGjLwBYmDqMFgB1Wtb5xZmCIfP69A1e9s7Ew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)
- [Rapport interviews](https://ugentbe-my.sharepoint.com/:b:/g/personal/rosh_gryson_ugent_be/EfWuEMYS2fZPpf3U9sw1PBIBbR0SOu7gSOZpQujpDS2X_A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)
- [Protocol literatuuronderzoek](https://ugentbe-my.sharepoint.com/:b:/g/personal/rosh_gryson_ugent_be/EarvmliUzitJqvhuUydt2U0B76wYVw16L-hvL3pKnRLV8Q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)
- [Rapport literatuuronderzoek](https://ugentbe-my.sharepoint.com/:b:/g/personal/rosh_gryson_ugent_be/EQi_aIOuugFJm0tf342ZD_cBkLjSMo3do-xiki7mVfhr5Q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)

**Deelopdracht 2: Definition**
- [Protocol gebruikstests](https://ugentbe-my.sharepoint.com/:b:/g/personal/rosh_gryson_ugent_be/EYI-YyfVlQNGoJw3irhUr8IB6O55q5miOOceDfL1jvSvsQ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)
- [Rapport gebruikstests](https://ugentbe-my.sharepoint.com/:b:/g/personal/rosh_gryson_ugent_be/ERjb5wzzgyhHkkviu3xgs4kBmaqyodQ1J_chhb6J3ZUipA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)
- [Storyboard](https://ugentbe-my.sharepoint.com/:b:/g/personal/rosh_gryson_ugent_be/EfTjkxJC3xRCkSqb8jPT_foBEXMmrpIbkWgbYjXi74KN9g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)

**Deelopdracht 3: Develop 1**
- [Protocol develop 1](https://ugentbe-my.sharepoint.com/:b:/g/personal/rosh_gryson_ugent_be/EYnQ5_UpWrZMqZonUhhwbUYB3qiD7yPpWkR4IYsoJCzTBQ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)
- [Rapport develop 1](https://ugentbe-my.sharepoint.com/:b:/g/personal/rosh_gryson_ugent_be/EcLrkE5KQL9KjGkvioypGBIBMkkocPpwzSfuyE07QG-s8w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)

**Deelopdracht 4: Develop 2**
- [Protocol develop 2](https://ugentbe-my.sharepoint.com/:b:/g/personal/rosh_gryson_ugent_be/EZr1qvLegvdGhiyvLIi9aaYBGahtcbnpVLFXi5PUhK0NEA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)
- [Rapport develop 2](https://ugentbe-my.sharepoint.com/:b:/g/personal/rosh_gryson_ugent_be/Ed8DPdIo2ZRFovkzM6mTZcQBQyfquAvjYD2CioEDKJAeWw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)

**Deelopdracht 5: Develop 3**
- [Protocol develop 3](https://ugentbe-my.sharepoint.com/:b:/g/personal/rosh_gryson_ugent_be/EXTqkAN2p1pOgIOTG9bTYhYB0weaJiqkyBv4y06PXGTpgw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)
- [Rapport develop 3](https://ugentbe-my.sharepoint.com/:b:/g/personal/rosh_gryson_ugent_be/EfC592EW2ZVPsl3D-SPsxN4BTB7b4cqZrUNqIZX2eIkBWg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)

## Bronnen

[^1]: Diedrich, N. (2020, Juli). _The Evolution-Driven Signature of Parkinson's Disease. CellPress._ (https://www.cell.com/trends/neurosciences/fulltext/S0166-2236(20)30103-X)
[^2]: Paul, S. Rosala, M. (2024, April). _The Wizard of Oz Method in UX. Nielsen Norman Group_ (https://www.nngroup.com/articles/wizard-of-oz/)
