rooooosh/CYR/Code/Python/Game_Design_Pygame/2 Snaredrum.png

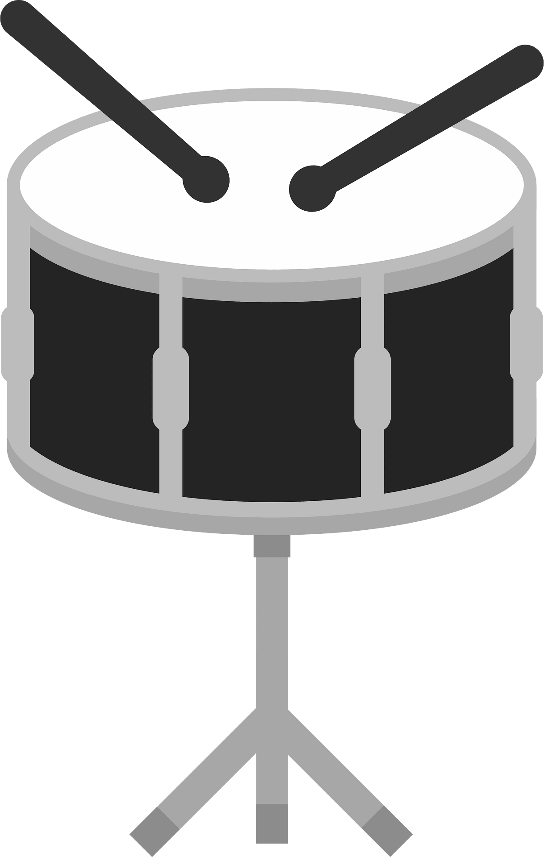
Code/Python/Game_Design_Pygame/2 Snaredrum.png
