rooooosh/CYR/Code/Python/Game_Design_Pygame/Drum Pedal.png

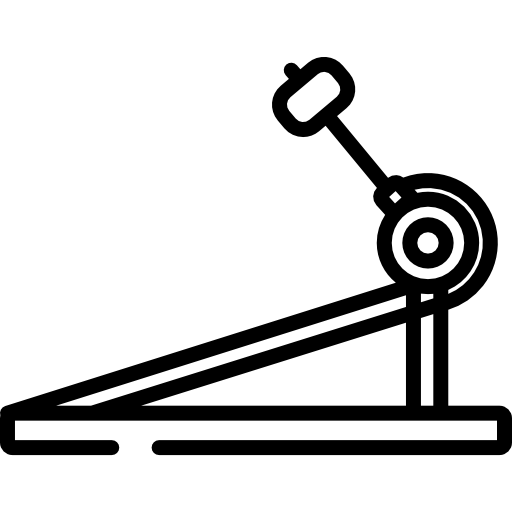
Code/Python/Game_Design_Pygame/Drum Pedal.png
