rooooosh/CYR/Code/Python/Game_Design_Pygame/hihat2.png

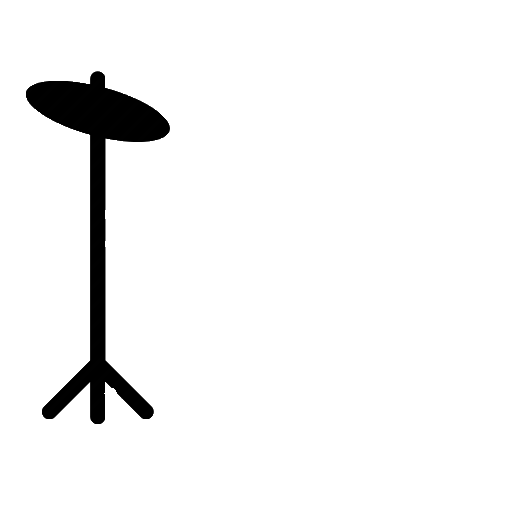
Code/Python/Game_Design_Pygame/hihat2.png
