rooooosh/CYR/Code/Python/Game_Design_Pygame/Snaredrum.png

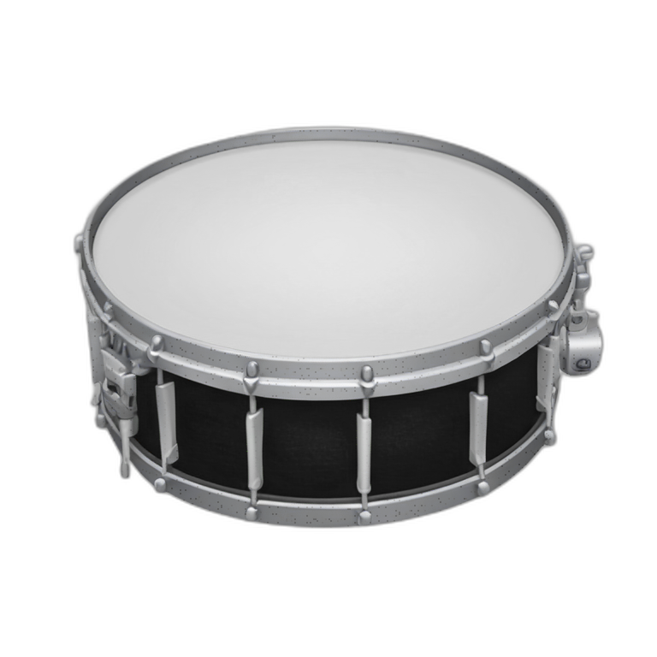
Code/Python/Game_Design_Pygame/Snaredrum.png
