rooooosh/CYR/Code/Python/Game_Design_Pygame/sticks.png

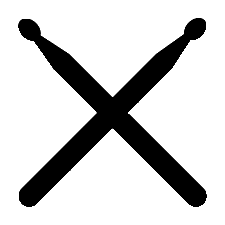
Code/Python/Game_Design_Pygame/sticks.png
