rooooosh/CYR/CYR PICS/Touchbox1.jpg

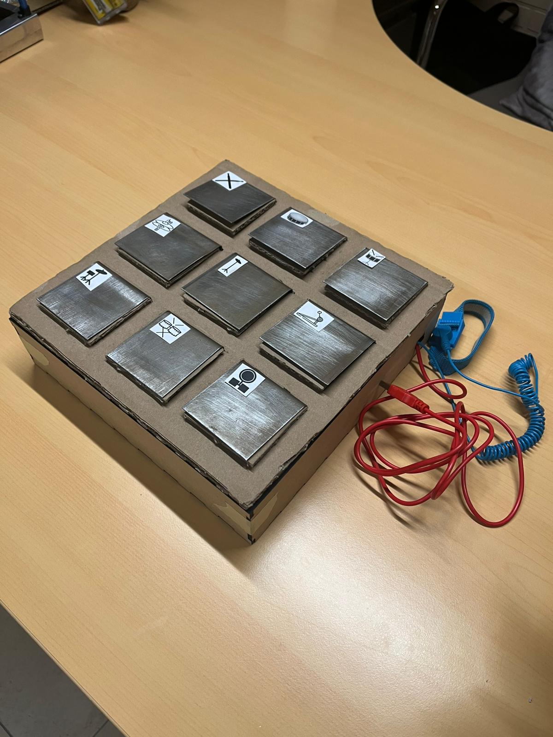
CYR PICS/Touchbox1.jpg
