rooooosh/CYR/CYR PICS/TEST2.jpeg

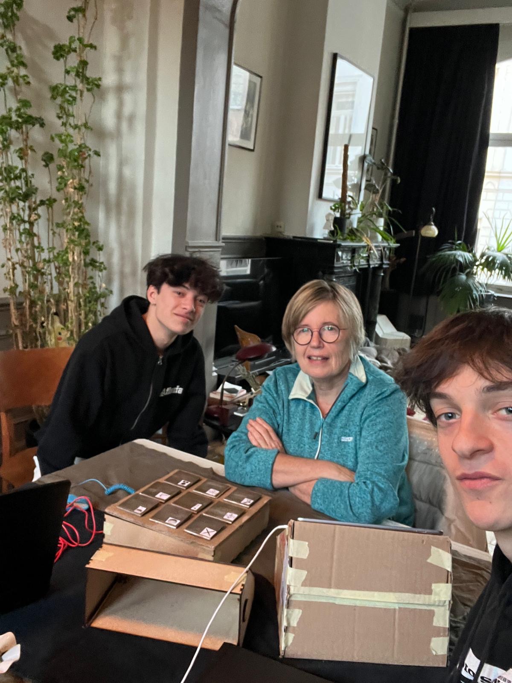
CYR PICS/TEST2.jpeg
