rooooosh/CYR/(commit log)

2025-04-23 Create Code Rotary encoder
2025-04-23 Rename Code Rotary encoder to Code.ino
2025-04-23 Update and rename Code Rotary Encoder to Code_Rotary_Encoder.ino
2025-05-15 Updated Code rotary encoder
2025-05-17 lijn in code die nog niet aangepast was
2025-05-23 Heb hier het formaat van de render beetje bijgewerkt
2025-05-23 BOM compleet.. Denk ik
2025-05-23 nope nog kleine aanpassing BOM
2025-05-23 Update Slotbevindingen
2025-05-23 Kostprijs bij BOM
