rooooosh/CYR/CYR PICS/CYR met Ipad.jpeg

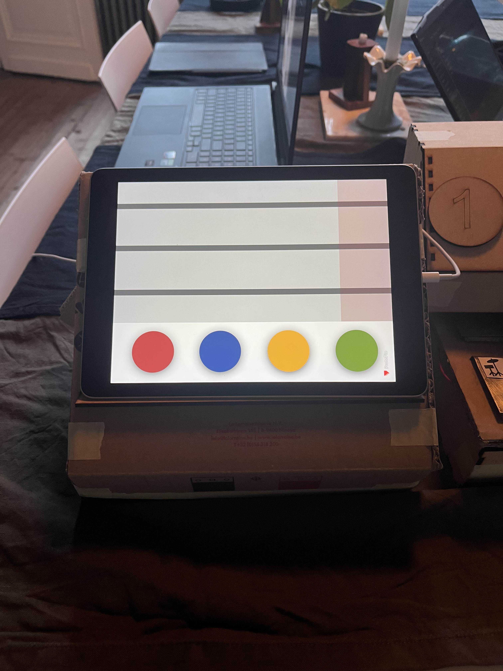
[picture p8: CYR PICS/CYR met Ipad.jpeg]
CYR PICS/CYR met Ipad.jpeg
