rooooosh/CYR/CYR PICS/ArduinoVolledig2.jpeg

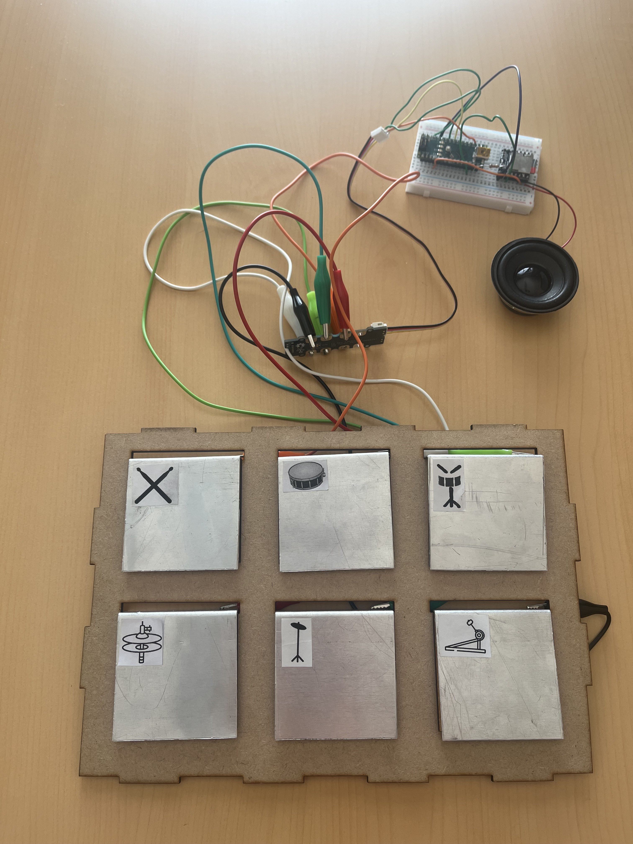
[picture p29: CYR PICS/ArduinoVolledig2.jpeg]
CYR PICS/ArduinoVolledig2.jpeg
