rooooosh/CYR/CYR PICS/Hendel1.jpeg

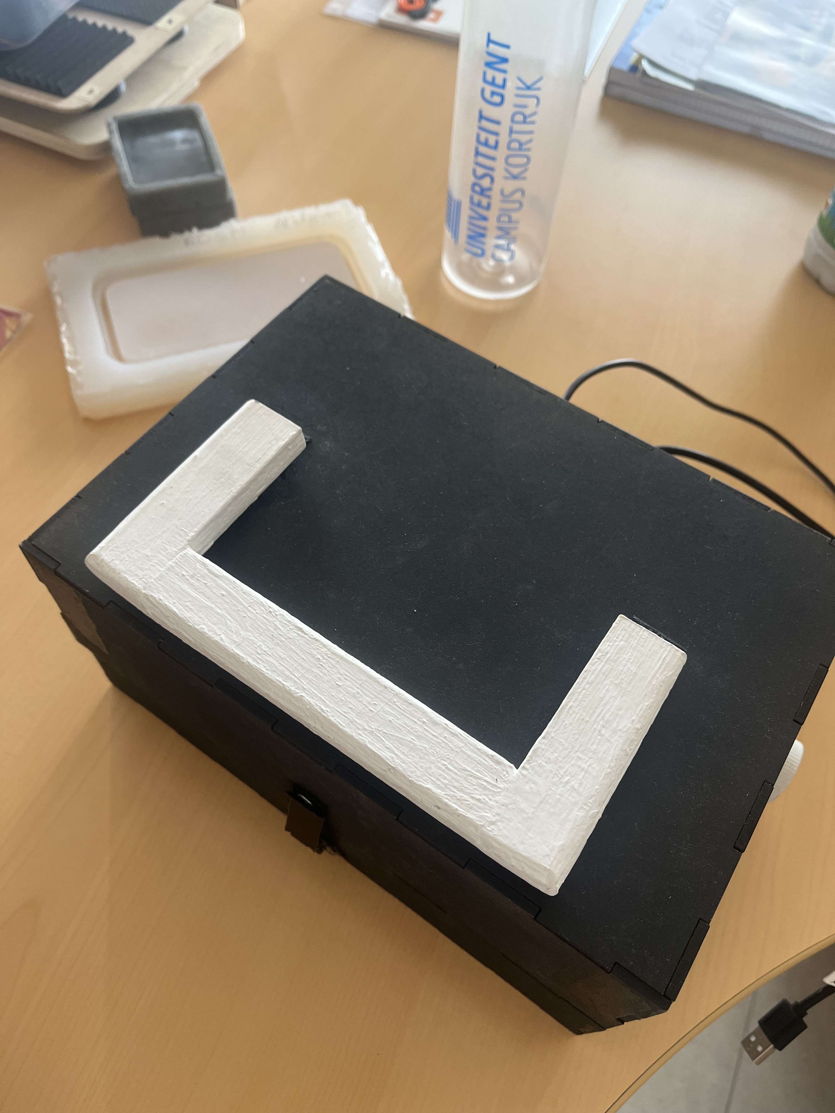
[picture p43: CYR PICS/Hendel1.jpeg]
CYR PICS/Hendel1.jpeg
