rooooosh/CYR/CYR PICS/Hendel2.jpeg

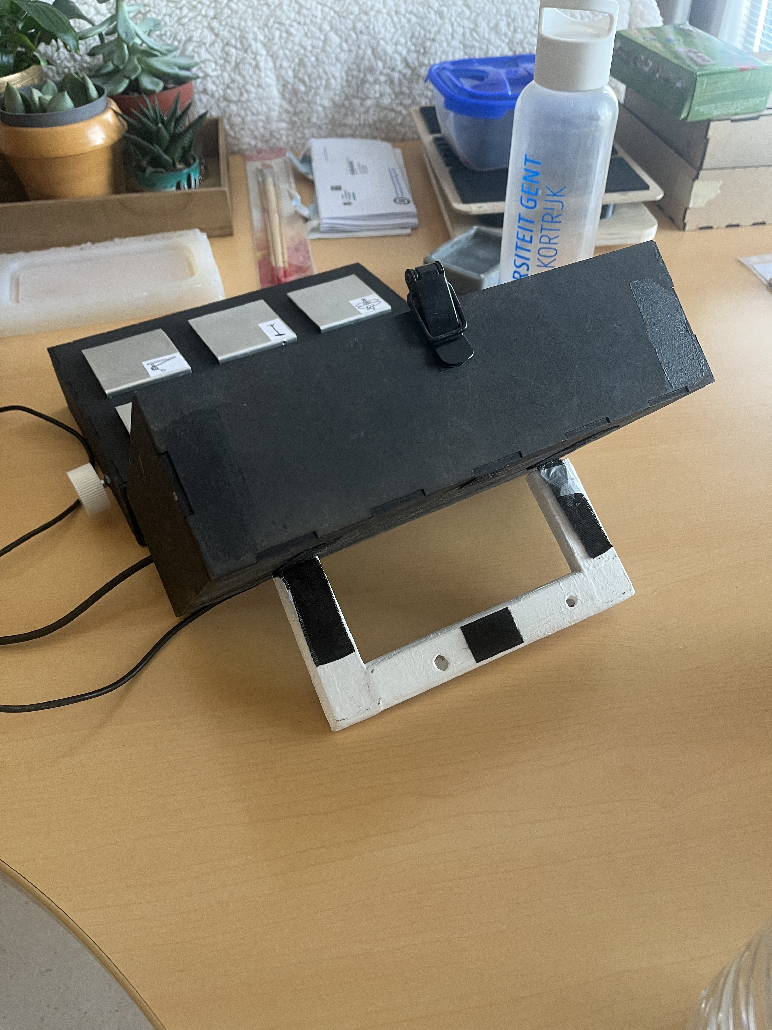
[picture p44: CYR PICS/Hendel2.jpeg]
CYR PICS/Hendel2.jpeg
